tmiw/SM1000neo/schematic/v1.0/ezDV.step

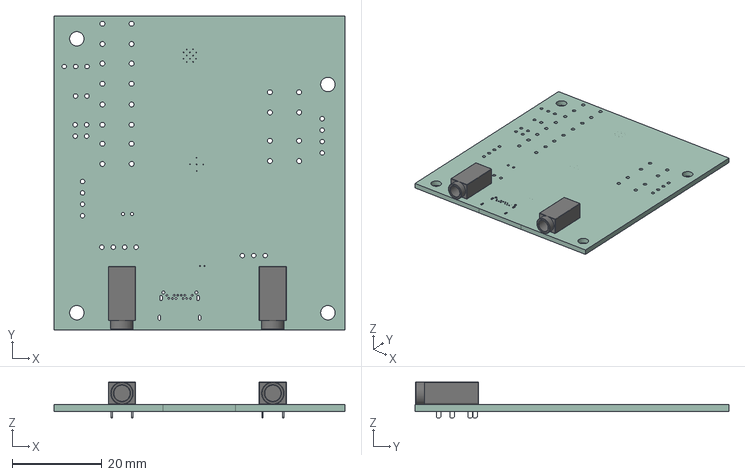
[picture p1: CAD file, 2024-10-30]
schematic/v1.0/ezDV.step
64.8 x 69.9 x 8.00 mm
ezDV PCB
