tmiw/SM1000neo/schematic/v1.0/ESD122DMXR.step

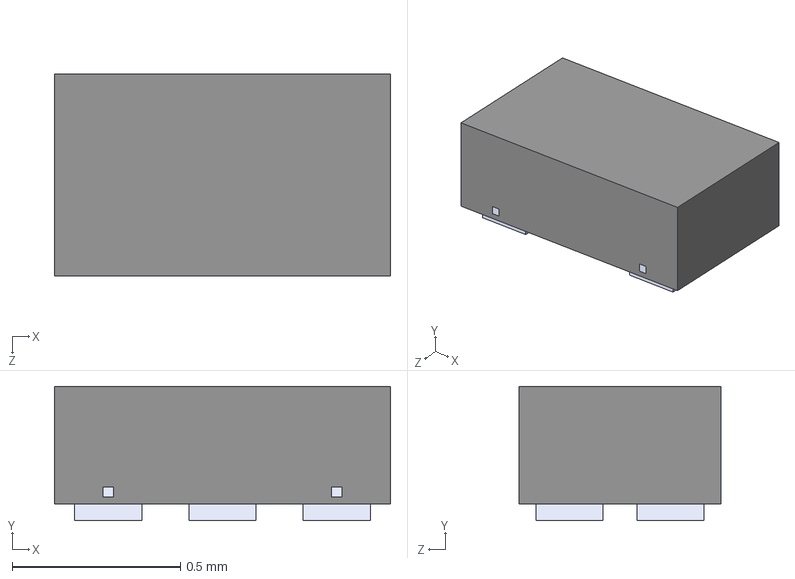
[picture p2: CAD file, 2024-10-30]
schematic/v1.0/ESD122DMXR.step
1.00 x 0.4 x 0.6 mm
