tmiw/SM1000neo/schematic/v1.0/BGA4N35P2X2_64X64X33N.step

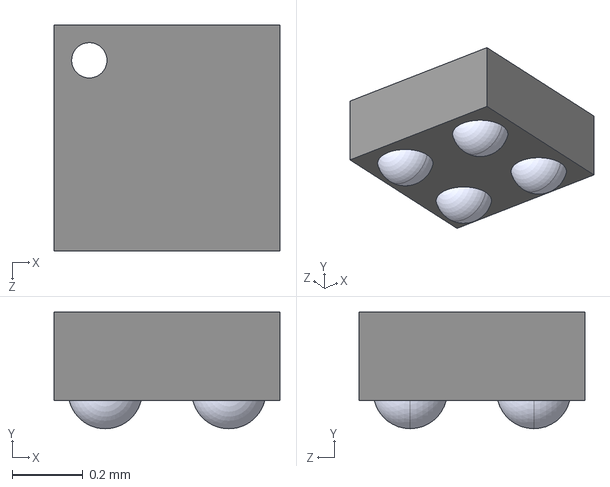
[picture p3: CAD file, 2024-10-30]
schematic/v1.0/BGA4N35P2X2_64X64X33N.step
0.64 x 0.33 x 0.64 mm
