tmiw/SM1000neo/schematic/v1.0/TPD1E05U06DPYR.step

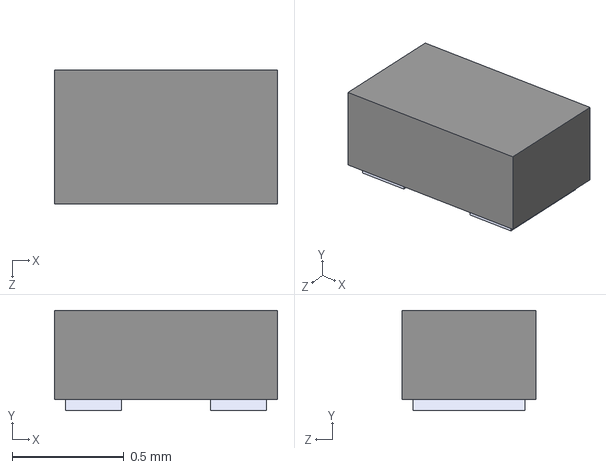
[picture p4: CAD file, 2024-10-30]
schematic/v1.0/TPD1E05U06DPYR.step
1.00 x 0.45 x 0.6 mm
