tmiw/SM1000neo/schematic/v1.0/TP4056.step

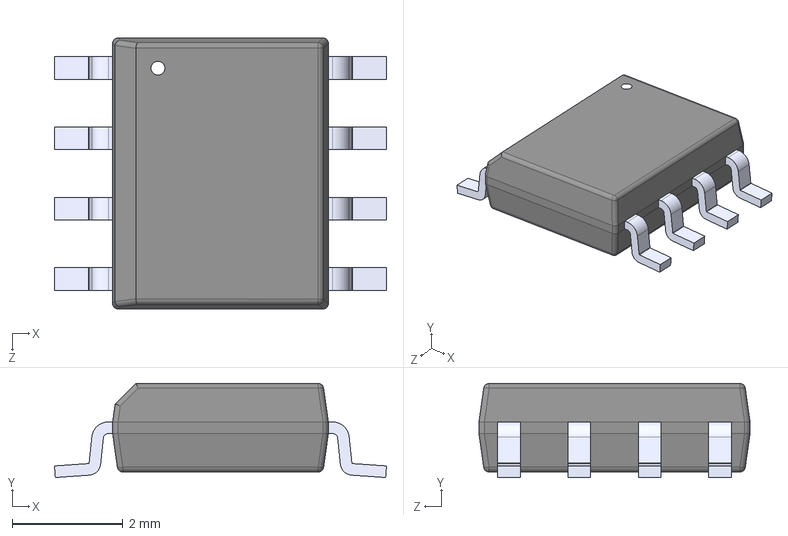
[picture p5: CAD file, 2024-10-30]
schematic/v1.0/TP4056.step
6.00 x 1.70 x 4.90 mm
