tmiw/SM1000neo/(threads)

Thread 2 (2022-05-06):

Evaluate and increase sizes of power traces

tmiw, 2022-05-06:
Some power traces may be insufficiently wide for the current being drawn. Investigate to confirm and update the PCB accordingly.

tmiw, 2022-05-29:
After rerouting of the PCB, the default trace width (0.25mm) was found to be sufficient for up to 1A of current at the top layer. The TLV320 as well as other components are unlikely to consume anywhere close to this current, so the issue can be closed.

Closed 2022-05-29.

Thread 3 (2022-05-06):

Remove button pullup resistors

tmiw, 2022-05-06:
The ESP32-S3 has internal pullups which may make R9, R12, R13 and R15 unnecessary. Evaluate and remove if those internal pullups are usable.

tmiw, 2022-05-28:
Closing for now as the current pullups seem to work okay.

Closed 2022-05-28.

Thread 4 (2022-05-06):

Evaluate size of I2C pullups

tmiw, 2022-05-06:
The I2C pullup resistors (R2 and R8) are currently 4.7K. This may be insufficient depending on how fast we drive the I2C bus. Investigate and increase the resistance if necessary.

tmiw, 2022-05-28:
I2C bus is able to be driven at 100KHz using 4.7K, so keeping as is.

Closed 2022-05-28.

Thread 5 (2022-05-06):

Add mounting holes for the dev board

tmiw, 2022-05-06:
v0.1 does not have any mounting holes. Adding some will eventually be needed for the final version or even future dev boards, so evaluate to determine what size/how many is appropriate.

Closed 2022-05-29.

Thread 6 (2022-05-06):

Evaluate and adjust resistor sizes for LEDs

tmiw, 2022-05-06:
The currents through each of the LEDs on v0.1 (R10, R14, R17 and R20) may produce dramatically different brightness levels. We can use PWM as a workaround but these should be readjusted based on the selected LEDs so that the brightness is approximately equal.

Closed 2022-05-29.

Thread 7 (2022-05-06):

Fix silkscreen readability issues

tmiw, 2022-05-06:
The EMC vias added just prior to sending the board to JLCPCB are interfering with some of the sillkscreen items. Move or delete the vias as appropriate so that the text is readable.

Closed 2022-05-29.

Thread 8 (2022-05-15):

Consider making R1 1k to increase mic bias current

tmiw, 2022-05-15:
Currently R1 is 2.7k (derived from the typical application schematic for the TLV320). However, this only allows 1mA of current to the microphone; the Android specs indicate 1.8-2.9 mA according to [this post](https://webcache.googleusercontent.com/search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). A 1k resistor instead would result in 2.5mA of current @ 2.5V, which would be within spec.

Closed 2022-05-29.

Thread 9 (2022-05-15):

Move I2C SCL to GPIO 45

tmiw, 2022-05-15:
v0.1 of the board has SCL on GPIO 48. However, the nanoESP32-S3 is apparently using that for its RGB LED. Cutting off the pin on the board for GPIO 45 and bodging the pin next to it to 45 allowed I2C to work properly.

Closed 2022-05-29.

Thread 10 (2022-05-17):

60Hz noise getting into headset mic line

tmiw, 2022-05-17:
Testing of the v0.1 boards show that significant 60Hz noise is getting into the mic line on the headset jack. The radio jack is working properly, however. For v0.2, we need to reroute this trace to shorten it and provide more shielding.

tmiw, 2022-06-25:
Looks like this was a firmware issue and not a HW issue. Still, v0.2 was worthwhile to spin. 👍

Closed 2022-06-25.

Thread 13 (2022-09-24):

Transition away from GitHub

tmiw, 2022-09-24:
As other FreeDV projects are transitioning away from GitHub, ezDV probably should too (context [here](https://sfconservancy.org/blog/2022/jun/30/give-up-github-launch/)). This issue is being created to track this task.

TODO:

* Research Git hosting providers (GitLab, SFC's own, etc.)
* Select Git hosting provider (w/vote by the Leadership Team)
* Clone current repo at new provider
* Re-enable/port CI tasks as appropriate
* Add link from GitHub to new location
* Make repository read-only mirror of new location
* Determine future date when to delete GitHub repository entirely

Related issues on other projects: codec2 (https://github.com/drowe67/codec2/issues/354), LPCNet (https://github.com/drowe67/LPCNet/issues/46), freedv-gui (https://github.com/drowe67/freedv-gui/issues/281)

Thread 14 (2022-10-13):

Thermistor is on incorrect GPIO pin

tmiw, 2022-10-13:
Oops. Turns out that the ADC only works on GPIOs 1-20 on the ESP32-S3. Reassign GPIO appropriately for next board spin.

tmiw, 2022-10-15:
Bodging to GPIO 18 for now. Final placement will be on v0.5 board.

tmiw, 2022-12-23:
Change has been integrated as of v0.5.

Closed 2022-12-23.

Thread 15 (2022-10-13):

High power consumption while off

tmiw, 2022-10-13:
Measuring ~890uA on v0.4 when turned off and USB is not plugged in. Per component datasheets, we should be seeing about 1/4-1/3 of that amount of consumption.

tmiw, 2022-12-23:
There were several causes:

1. The ULP coprocessor consumes more power than initially thought. SW changes (putting fuel gauge chip into hibernate manually as well as only activating the ULP 10x/sec to check the Mode button state) cut power consumption from ~770 uA to ~365 uA.
2. The pullup for `TLV320_RESET` was attached to `3.3V` instead of `3.3V_PERIPH`, causing ~300+ uA of leakage current to flow through the TLV320/ESP32 to the rest of the system. Desoldering R17 on v0.5 cut power consumption to ~50 uA after performing the changes in (1).

R17 has been removed in the schematic in `master` and will be integrated in the next board spin. While the board now meets the target (>= 1 year powered off before a 2000 mAh battery dies), there is still room for further improvement through selection of a different LDO. Keeping this issue open until we decide whether the LDO should be replaced.

tmiw, 2023-02-19:
v0.6 brought this down to ~25uA, so we can close this issue now.

Closed 2023-02-19.

Thread 16 (2022-10-13):

Microphone noise with TLV320 headset detection turned on

tmiw, 2022-10-13:
With headset detection turned on, there's some sort of background noise in the audio while in loopback mode. May need to inspect this part of the circuit again and ensure any RFI, etc. is taken care of.

tmiw, 2022-12-23:
Rerouted headset detect trace in v0.5 and resolved this issue.

Closed 2022-12-23.

Thread 17 (2022-10-18):

Move LED/PTT GPIO to RTC GPIO

tmiw, 2022-10-18:
Some LEDs are on dimly in sleep mode, which could be contributing to the high power consumption (see #15). For v0.5, we should switch the GPIOs around to avoid this issue.

tmiw, 2022-12-23:
LEDs are controlled via `3.3V_PERIPH` as of HW revision v0.5.

Closed 2022-12-23.

Thread 18 (2022-12-23):

Network LED much dimmer than the others

tmiw, 2022-12-23:
After desoldering R17 (see #15), I noticed that the network LED was much dimmer than the others. As a workaround, I enabled PWM on the LED GPIOs (https://github.com/tmiw/ezDV/commit/b49d4518e9d7d4edd33408c669c34078d787b349) and set it to ~10% duty cycle to minimize the dimming.  Needs more investigation to determine if there's a hardware problem.

tmiw, 2022-12-26:
Appears to be a firmware bug, fixed as of https://github.com/tmiw/ezDV/commit/c7b59d29f85121c067ee88c8e6f6925c029a9a6f.

Closed 2022-12-26.

Thread 19 (2023-07-20):

Crypto support + PCB manufacturing procedure

danielebruneo, 2023-07-20:
Hi,
I've been following your project and loving all the work you've done.

This overlap perfectly with a project I was researching on: building a crypto transciever based on an ESP (something similar to what aarmono did here: https://github.com/aarmono/crypto_transceiver_instructions but cheaper and smaller).

I would then like to start contributing to your project, maybe trying to port the work aarmono did on top of codec2 to build encryption support. (Is this something you were already thinking about, maybe?)

First thing, though, I'd need to get some hardware to develop with.

Any chance there is a ready-to-go package or instructions to get a set of pcb manufactured by any PCBA provider?

oh2lak, 2023-07-20:
What is the need for encryption, as amateur radio traffic in 99% of the
countries do not allow encryption?

Br,
Erik OH2LAK

On Thu, 20 Jul 2023 at 12:32, danielebruneo ***@***.***>
wrote:

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

tmiw, 2023-07-20:
The BOM is built into the KiCad files, but there are specific settings you have to choose at JLCPCB to have it built properly. I'll write up a document on that when I have time (likely not until at least next week).

As for crypto support, I'll leave it to @danielebruneo's fork as ezDV itself is intended for amateur radio use.

tmiw, 2024-05-18:
Closing as dupe of #21.

Closed 2024-05-18.

Thread 20 (2023-08-28):

More options for the FreeDV (int) Reporter

barjac, 2023-08-28:
Since the QST article about FreeDV has been published it has become clear that the reporter needs to have more fine grained setting options.
It's great to see more stations on the bands, but on 20m especially the reporter is becoming difficult to read in use.
Suggestions:
1 A filter to remove calls that have not been updated in the last N mins.
2 An option to only display (or highlight?) calls who have received me in the last N mins).
3 Show my own call line in a different colour.
4 An option to switch the reporter band filter automatically to the currently reported band (but only when that changes). i.e. The reporter band selector would still over-ride.

Just few ideas for discussion ;)

tmiw, 2023-08-28:
Please create this in the main freedv-gui repo instead as this has to do with functionality in that application. ezDV, while it does support reporting to FreeDV Reporter, has no internal display capability.

Closed 2023-08-28.

Thread 21 (2023-08-30):

ezDV build process document

g0kao, 2023-08-30:
Suggested starter for documenting the build process for the ezDV module based on HW Version 0.7 and my experience so far.
[ezDV Build Process.pdf](https://github.com/tmiw/ezDV/files/12474881/ezDV.Build.Process.pdf)
I couldn't create a pull request to have it reviewed, possibly not authorised for this project
hope it is useful and review comments welcomed
I generated in Text Edit on the Mac and exported to PDF to add it here
Paul

tmiw, 2023-08-31:
Thanks for this! I'll take a closer look when I have a chance. There might be the possibility of having JLCPCB fully assemble the boards (so you'd only need to buy the battery separately) so the instructions will likely need modification when that happens.

Thread 22 (2023-09-05):

WiFi unable to disable

g0kao, 2023-09-05:
Testing the ezDV module using two radios, one IC-705 the other a Yaesu FTdx10, Wifi enabled for the 705 which seems to be working ok, but when trying to focus efforts on the dx10, am unable to disable the WiFi connectivity for the radio.
Whenever i untick the option for WiFi connectivity and try to save, it reverts back to previous settings without unticking the WiFi option.
Have to disable WiFi on the 705 to force connectivity to work with the dx10
Have updated to latest version of code just released via ota but no change in the WiFi issue

tmiw, 2023-09-05:
Do you see any red or green popup boxes on the page after you press Save? If you see a green "success" type message, keep in mind that Wi-Fi changes require a power cycle (or pushing the Reboot button in the web UI) to take effect.

g0kao, 2023-09-05:
I untick the wifi check box, the config clears, I click the Save button, the module resets itself
when it comes back online the wifi is still enabled.
I did an ota update with the new release but it didn.t change anything, should I try a fresh full reflash perhaps?

g0kao, 2023-09-05:
I reflashed the module as discussed, I haven't connected to the ic-705, i just enabled the wifi, reset the module, then when it came back I attempted to disable wifi to the radio and the same steps occurred as outlined above, wifi not disable to the radio. going to try something else like disabling wifi completely from the module as a complete reset of the wifi code and see what happens

g0kao, 2023-09-05:
Nope, cannot disable wifi either, very strange, if i click the reset button on the wifi radio page, it defaults to some preconfigured default info, the black circle continues circling with no other prompts, it appears that once configured it cannot be undone without a reflash for me anyway. I  have one last ditch idea, will let you know what happens

g0kao, 2023-09-05:
attached is a putty log, tried to disable radio wifi, didn't work, then tried to disable wifi as a service, that did not work either
[putty-ezDV-wifi-issue.txt](https://github.com/tmiw/ezDV/files/12525971/putty-ezDV-wifi-issue.txt)

tmiw, 2023-09-06:
Give tonight's release a shot and let me know how it goes: https://github.com/tmiw/ezDV/releases/tag/20230905

g0kao, 2023-09-06:
Thanks Mooneer, that has fixed the problem, I can disable wifi or the wifi radio connection and re-enable the radio connection as needed, thanks again

Closed 2023-09-06.

Thread 23 (2023-09-24):

revised enclosure top and buttons

g0kao, 2023-09-24:
Having had the enclosure built for me I discovered that when the module v0.7 was fitted, the top did not fit due to the headers fitted to the pcb, as a result I have adjusted the height of the top and the length of the buttons to cater for the new case height.
Attached are new scad files that I have created and successfully printed to fit this module.
enclosure-lid.scad
enclosure-button-v3.scad
[enclosure-new-files.zip](https://github.com/tmiw/ezDV/files/12709445/enclosure-new-files.zip)

tmiw, 2023-09-25:
Thanks for these. How are you routing the cables attached to the headers out? I didn't see any additional holes when I opened them in OpenSCAD.

g0kao, 2023-09-25:
On mine I haven't created any holes for leads to come out from headers, managed connectivity via audio TRRS sockets for DX10 and wifi for ic-705. When original case was made I drilled a hole in the lid directly above the dc connection for the battery and chopped the header pins down so the lid would fit enough with the help of electrical tape to hold it together :-)
Need to make a fix so that the 3d printed buttons don't fall out when the module is tipped over, I think some tiny rubber o-rings should do it if I can find some small enough :-)
Attached is pic of my completed module using the files uploaded on my 3d printer
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

tmiw, 2023-09-25:
Ah, okay. I actually intended the headers to be optional since most will either be using the 3.5mm jacks and/or Wi-Fi, but it won't hurt to update the main OpenSCAD files with an extra flag that can be set to print the bigger case.

Re: O-rings, that sounds like a pretty good idea. I was thinking post-processing by adding tiny dabs of glue to the bottoms of the buttons but that precludes removing them later :)

tmiw, 2023-09-26:
I integrated the changes you provided into the main `enclosure.scad` file. The taller enclosure can be requested by setting the below (near the top of the file) to true:

```
// Whether to print a taller enclosure to fit e.g. pin headers.
// Note: this weirdly has to be above the include line for some reason.
printTallerEnclosure = false;
```

and likewise for `enclosure-button.scad`:

```
// Whether to print a taller buttons (typically used when printing the taller enclosure).
printTallerButtons = false;
```

Let me know if that doesn't work for you and I can reopen and investigate further.

Closed 2023-09-26.

Thread 24 (2023-11-01):

System stuck if no MAX17048 is used

onemikedelta, 2023-11-01:
I planned to use this module without battery. Everything works however, if I try to connect web interface system reboots.
Library shouldn't try to read battery if ic is not found during boot process.
`
I (22945) ButtonArray: Button VolDown now 0
I (23925) SettingsTask: Committing pending settings to flash.
I (40405) wifi:new:<1,0>, old:<1,1>, ap:<1,1>, sta:<255,255>, prof:1
I (40405) wifi:station: 12:34:56:78:90:AB join, AID=1, bgn, 20
I (40405) WirelessTask: Wifi event: 14
I (40535) wifi:<ba-add>idx:2 (ifx:1, 12:75:8d:8e:1d:67), tid:0, ssn:0, winSize:64
I (40745) esp_netif_lwip: DHCP server assigned IP to a client, IP is: 192.168.4.2
I (40765) DVTask: Task FlexVitaTask started
I (57075) HttpServerTask: Sending file : /bootstrap.min.css.gz (27324 bytes)...
I (57195) HttpServerTask: File sending complete
I (57285) HttpServerTask: Sending file : /localstyle.css (3249 bytes)...
I (57295) HttpServerTask: File sending complete
I (57385) HttpServerTask: Sending file : /bootstrap.bundle.min.js.gz (23265 bytes)...
I (57485) HttpServerTask: File sending complete
I (57495) HttpServerTask: Sending file : /jquery-3.6.1.min.js.gz (30850 bytes)...
I (57625) HttpServerTask: File sending complete
I (57715) HttpServerTask: Sending file : /localscript.js (22156 bytes)...
I (57845) HttpServerTask: File sending complete
I (57885) HttpServerTask: Websocket connection opened
I (57885) HttpServerTask: Sending JSON message to socket 57
I (57885) HttpServerTask: Sending JSON message to socket 57
I (57885) HttpServerTask: Sending JSON message to socket 57
I (57895) HttpServerTask: Sending JSON message to socket 57
I (57895) HttpServerTask: Sending JSON message to socket 57
I (57895) HttpServerTask: Sending JSON message to socket 57
I (57905) HttpServerTask: Sending JSON message to socket 57

assert failed: void ezdv::driver::MAX17048::onRequestBatteryStateMessage_(ezdv::task::DVTask*, ezdv::driver::RequestBatteryStateMessage*) MAX17048.cpp:215 (success)

Backtrace: 0x40376016:0x3fca9000 0x40380f31:0x3fca9020 0x40388c26:0x3fca9040 0x42015eca:0x3fca9160 0x42127fca:0x3fca91e0 0x42016639:0x3fca9200 0x42016649:0x3fca9230 0x420162a9:0x3fca9250 0x420162bf:0x3fca9280 0x42022369:0x3fca92a0 0x420223d6:0x3fca92f0 0x42022415:0x3fca9310 0x4038459d:0x3fca9330

------------------
I (1202) MAX17048: Checking for device...
W (1302) MAX17048: Device not found; battery monitoring disabled.
I (1302) DVTask: Task MAX17048 started
I (1312) DVTask: Task LedArray started
I (1322) gpio: GPIO[4]| InputEn: 0| OutputEn: 0| OpenDrain: 0| Pullup: 1| Pulldown: 0| Intr:0
I (1322) gpio: GPIO[5]| InputEn: 0| OutputEn: 0| OpenDrain: 0| Pullup: 1| Pulldown: 0| Intr:0
I (1322) gpio: GPIO[6]| InputEn: 0| OutputEn: 0| OpenDrain: 0| Pullup: 1| Pulldown: 0| Intr:0
I (1322) gpio: GPIO[7]| InputEn: 0| OutputEn: 0| OpenDrain: 0| Pullup: 1| Pulldown: 0| Intr:0
I (1322) gpio: GPIO[0]| InputEn: 0| OutputEn: 0| OpenDrain: 0| Pullup: 1| Pulldown: 0| Intr:0
I (1322) DVTask: Task ButtonArray started
I (1332) TLV320Driver: reset TLV320
I (1332) TLV320Driver: configure clocks
I (1342) TLV320Driver: configure processing blocks
I (1342) TLV320Driver: configure LDOs
I (1342) TLV320Driver: configure routing for ADC
I (1352) TLV320Driver: configure routing for DAC
I (1602) ButtonArray: Button UsbPower now 1
I (3182) TLV320Driver: configuring interrupts
I (3182) gpio: GPIO[12]| InputEn: 0| OutputEn: 0| OpenDrain: 0| Pullup: 1| Pulldown: 0| Intr:0
I (3182) gpio: GPIO[14]| InputEn: 0| OutputEn: 0| OpenDrain: 0| Pullup: 1| Pulldown: 0| Intr:0
I (3182) TLV320Driver: all audio codec config complete
I (3182) DVTask: Task TLV320Driver started
W (3202) TLV320Driver: ADC overload! (Left/User = 1, Right/Radio = 0)
I (3292) DVTask: Task FreeDVTask started
I (3302) DVTask: Task AudioMixer started
I (3302) TLV320Driver: button state: 10
I (3312) DVTask: Task BeeperTask started
I (3322) VoiceKeyerTask: Starting VoiceKeyerTask
I (3322) DVTask: Task VoiceKeyerTask started
I (3332) UserInterfaceTask: Sending welcome message to beeper
I (3332) DVTask: Task UserInterfaceTask started
I (3332) BeeperTask: Got beeper message   ANA
I (3342) DVTask: Task WirelessTask started
I (3342) DVTask: Task MainApp started
I (3352) SettingsTask: Initializing NVS.
I (3352) SoftwareUpdateTask: Starting SoftwareUpdateTask
I (3352) DVTask: Task SoftwareUpdateTask started
I (3352) SettingsTask: Opening NVS handle.
I (3352) SettingsTask: leftChannelVolume: 10
I (3352) SettingsTask: rightChannelVolume: -35
I (3352) SettingsTask: wifiEnabled: 0
I (3352) SettingsTask: wifiMode: 0
I (3352) SettingsTask: wifiSecurity: 0
I (3352) SettingsTask: wifiChannel: 1
I (3352) SettingsTask: wifiSsid:
I (3362) TLV320Driver: Volume control: setting volume on register 65 to 10
I (3362) SettingsTask: wifiPassword: ********
I (3362) SettingsTask: radioEnabled: 0
I (3362) SettingsTask: headsetPtt: 0
I (3362) SettingsTask: timeOutTimer: 120
I (3362) SettingsTask: radioType: 0
I (3362) SettingsTask: radioHostname:
I (3362) SettingsTask: radioPort: 0
I (3362) SettingsTask: radioUsername:
I (3362) SettingsTask: radioPassword: ********
I (3362) UserInterfaceTask: Disallowing headset button from toggling PTT.
I (3362) SettingsTask: enableVoiceKeyer: 0
I (3362) SettingsTask: voiceKeyerNumberTimesToTransmit: 10
I (3362) SettingsTask: voiceKeyerSecondsToWaitAfterTransmit: 5
I (3362) SettingsTask: callsign:
I (3362) SettingsTask: gridSquare: UN00KN
I (3362) SettingsTask: ledDutyCycle: 8192
I (3362) SettingsTask: lastMode: 3
I (3362) DVTask: Task SettingsTask started
I (3362) FreeDV: Setting FreeDV mode to 3
I (3362) BeeperTask: Got beeper message   1600
I (3372) TLV320Driver: Volume control: setting volume on register 66 to -35

`

tmiw, 2023-11-01:
ezDV is intended for use with a battery. Did you simply not populate the chip when you built it, or did you make additional changes?

Regardless, there is logic in there to detect the presence of the MAX17048 but the result of that is apparently getting ignored. That should hopefully be a quick fix that I can get to tonight.

tmiw, 2023-11-02:
This should be fixed in 2f396cb. Please confirm and I can go ahead and close. Thanks for letting me know!

onemikedelta, 2023-11-02:
You are welcome, thank you for such a fast action. It works normal now. I didn't populated the chip on one pcb.
I tryed to solder on another pcb but it completely stopped booting.

`I (668) sleep: Configure to isolate all GPIO pins in sleep state
I (669) sleep: Enable automatic switching of GPIO sleep configuration
I (669) app_start: Starting scheduler on CPU0
I (669) app_start: Starting scheduler on CPU1
I (669) main_task: Started on CPU0
I (679) esp_psram: Reserving pool of 63K of internal memory for DMA/internal all                                     ocations
I (679) main_task: Calling app_main()
I (779) gpio: GPIO[1]| InputEn: 0| OutputEn: 0| OpenDrain: 0| Pullup: 1| Pulldow                                     n: 0| Intr:0
I (779) gpio: GPIO[2]| InputEn: 0| OutputEn: 0| OpenDrain: 0| Pullup: 1| Pulldow                                     n: 0| Intr:0
I (779) gpio: GPIO[15]| InputEn: 0| OutputEn: 0| OpenDrain: 0| Pullup: 1| Pulldo                                     wn: 0| Intr:0
I (779) gpio: GPIO[21]| InputEn: 0| OutputEn: 0| OpenDrain: 0| Pullup: 1| Pulldo                                     wn: 0| Intr:0
I (779) gpio: GPIO[16]| InputEn: 0| OutputEn: 0| OpenDrain: 0| Pullup: 1| Pulldo                                     wn: 0| Intr:0
I (779) app: Wakeup reason: 0
I (779) app: Power up mode: 2773393973
I (779) app: Woken up via ULP, booting...
I (779) main_task: Returned from app_main()
I (789) app: onTaskStart_
I (809) gpio: GPIO[3]| InputEn: 0| OutputEn: 0| OpenDrain: 0| Pullup: 1| Pulldow                                     n: 0| Intr:0
I (809) gpio: GPIO[9]| InputEn: 0| OutputEn: 0| OpenDrain: 0| Pullup: 1| Pulldow                                     n: 0| Intr:0
I (809) gpio: GPIO[10]| InputEn: 0| OutputEn: 0| OpenDrain: 0| Pullup: 1| Pulldo                                     wn: 0| Intr:0
I (809) gpio: GPIO[11]| InputEn: 0| OutputEn: 0| OpenDrain: 0| Pullup: 1| Pulldo                                     wn: 0| Intr:0
I (809) gpio: GPIO[12]| InputEn: 0| OutputEn: 0| OpenDrain: 0| Pullup: 1| Pulldo                                     wn: 0| Intr:0
I (809) gpio: GPIO[14]| InputEn: 0| OutputEn: 0| OpenDrain: 0| Pullup: 1| Pulldo                                     wn: 0| Intr:0
I (809) gpio: GPIO[13]| InputEn: 0| OutputEn: 0| OpenDrain: 0| Pullup: 1| Pulldo                                     wn: 0| Intr:0
I (809) gpio: GPIO[0]| InputEn: 0| OutputEn: 0| OpenDrain: 0| Pullup: 1| Pulldow                                     n: 0| Intr:0
I (819) gpio: GPIO[7]| InputEn: 0| OutputEn: 0| OpenDrain: 0| Pullup: 1| Pulldow                                     n: 0| Intr:0
I (819) gpio: GPIO[4]| InputEn: 0| OutputEn: 0| OpenDrain: 0| Pullup: 1| Pulldow                                     n: 0| Intr:0
I (829) MAX17048: Checking for device...
E (1829) DVTask: Was waiting for MAX17048 but timed out
W (1929) MAX17048: Device not found; battery monitoring disabled.
I (1929) DVTask: Task MAX17048 started

assert failed: void ezdv::task::DVTask::waitForOurs_(ezdv::task::DVTask*, TickTy                                     pe_t) [with ControlMessageType = ezdv::task::TaskControlCommon<3>; TickType_t =                                      long unsigned int] DVTask.h:346 (found)

Backtrace: 0x4037677a:0x3fcbca90 0x4038124d:0x3fcbcab0 0x40388faa:0x3fcbcad0 0x4                                     2021cdd:0x3fcbcbf0 0x42021d59:0x3fcbcc20 0x4200ac8c:0x3fcbcc60 0x42020e96:0x3fcb                                     cca0 0x42122b9d:0x3fcbccd0 0x42020559:0x3fcbcd00 0x4202111a:0x3fcbcd30 0x4202122                                     2:0x3fcbcd80 0x4202127d:0x3fcbcda0 0x40381c01:0x3fcbcdc0
`

tmiw, 2023-11-02:
I added a bit more timeout for the MAX17048 task based on my testing here with an earlier version that doesn't have the MAX17048. Hopefully that helps!

onemikedelta, 2023-11-02:
Now the battery part works perfect. Thank you again, 73

Closed 2023-11-02.

Thread 25 (2023-11-29):

Analog Bypass Feature

onemikedelta, 2023-11-29:
Analog Bypass
If we switch IN1_L and IN1_R in the future versions, it looks like we may have a low power analog bypass mode, which will reduce latency and we can put esp32 into sleep mode to save power.

We may add speaker amplifier to LOL line and internal mic to one of the available inputs, (preferably analog routable one). So, the device can be usable as an ordinary hand mike. I have added LM4871MX on my pcb and routed LOL to this pin, it works nice. We only need to implement some amplifier enable signal other than Sync output because this output flickers a lot and continuously turn amplifier on and off. I have tryed headphone detect interrupt to switch headphone/speaker channels however it is not working, probably allways connected radio channel is preventing that, not sure atm.

Just a few ideas, 73

tmiw, 2023-11-29:
I remember the TLV320 being pretty low power even without using its analog bypass mode. The ESP32-S3 (and the status LEDs to a smaller extent) by far use most of the power. That said, using the mixer amps may be possible for RX; see below from the Application Reference Guide:

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

(Basically, set HPL to MAR, which comes from IN1_R.)

However, on TX, the ESP32 would probably have to come back online to take back control of audio routing, which will take a second or two if coming from ULP sleep. Not sure users would be okay with that, to be honest.

onemikedelta, 2023-11-29:
The problem is we cannot route microphone to the radio in this configuration if I am not missing a path. MAL to HPR is not supported. For the PTT, we may introduce a simple diode from radio PTT to PTT button. Only thing that is not going to work is PTT LED. I haven't tryed to setup interrupt for button and use GPIO21 yet. Maybe we can achieve this ptt system without waking up mcu completely by using ULP.

tmiw, 2023-11-29:
I don't have the schematic in front of me but I think the PTT output pin is one that can be manipulated in ULP. Would just need hardware changes to enable the proper routing if you did want to be able to support low powered analog.

That said, switching from that mode would likely still take a few seconds, but that might still be okay. Let's put this on hold for now and consider for ezDV V2.

Thread 26 (2023-12-04):

Reporting page - add ability to report via reporter the current mode and frequency

g0kao, 2023-12-04:
A thought just came to me as I was using the module with my FTdx10 connected via rear port. The module doesn't report to FreeDV Reporter when being used as we have previously discussed when I was initially testing.
Could the module reporting page where Callsign and Locator are configured be updated to allow entry of Frequency and Mode currently being used?  most people will be using their computer maybe to change modes or just keep an eye on battery levels so would be a useful way of enabling reporting via reporter at the same time for those where the rigs cannot communicate to the module their settings.

tmiw, 2023-12-06:
Give https://github.com/tmiw/ezDV/releases/tag/20231206 a shot and let me know how it goes. If you have problems with that, I can go ahead and reopen this bug for further investigation.

Closed 2023-12-06.

Thread 27 (2023-12-05):

Analog Mode Rx not working after Tx

onemikedelta, 2023-12-05:
In analog mode audio routing is ok after device reset. Transmit is also ok. However, It is not routing back the radio audio to the user audio.
Used firmware: ezdv-20231122-full

tmiw, 2023-12-05:
I believe https://github.com/tmiw/ezDV/commit/89552ddb52b05465ed2de981ccec28808de11187 will fix this based on my testing with SmartSDR and the Flex 6300 here. The issue was that there was logic missing to return to RX mode when in analog; I suspect if you push the Mode button after letting go of PTT to switch to e.g. 700D (and then go back to analog), RX will start working fine again.

Anyway, feel free to update here if it's still not solved after the next FW update and I'll reopen and investigate further.

Closed 2023-12-05.

Thread 31 (2024-03-19):

ezDV does not unregister itself from SmartSDR

tmiw, 2024-03-19:
Currently there is logic in ezDV (in `FlexTcpTask.cpp`) that unregisters itself from Flex radios when shutting down, and could presumably be run as well after a brief disconnection. However, when running this logic, the radio itself crashes. Thus, in the current FW, this logic is disabled.

The crash is being tracked by FlexRadio as SMART-9473 and this issue will be open until confirmed to be fixed (and the logic can be reenabled).

Thread 41 (2024-05-18):

Add references to FlexRadio 8000 series

tmiw, 2024-05-18:
Current references in the web interface and user's guide mention the FlexRadio 6000 series, but these need to be updated due to [FlexRadio's announcement of the 8400/8600](https://www.flexradio.com/products/flex-8000-deposit/?sku=FLEX-8000-Deposit-FL) at the 2024 Dayton Hamvention. No breaking changes to their API are expected in the new lineup.

Closed 2024-05-24.

Thread 59 (2024-07-29):

ezDV firmware build issues

FreeRepositories, 2024-07-29:
Hi,
Trying to build the firmware,  (commit 7ee14a9 v1.1.0)  but it looks it cannot be built.
Seen that in Releases there is a pre-built firmware, I wonder what is happening.
Are the repo sources checked out, up to date ?

Tried this many times, with the same error results.

New environment, Ubuntu 24.04, fresh esp-idf v 5.3

In a nutshell, what is executed is

**git clone https://github.com/tmiw/ezDV.git**
**cd ezDV**
**git submodule update --init --checkout --recursive**
**cd firmware**
**idf.py build**

 and then it stops with

```
/home/user/esp/projects/ezDV/firmware/main/network/HttpServerTask.cpp:612:28: error: 'using ezdv::network::HttpServerTask::WebSocketList = class std::map<int, bool>' {aka 'class std::map<int, bool>'} has no member named 'contains'
  612 |     if (!activeWebSockets_.contains(message->fd))
      |                            ^~~~~~~~
/home/user/esp/projects/ezDV/firmware/main/network/HttpServerTask.cpp: In member function 'void ezdv::network::HttpServerTask::onHttpWebsocketDisconnectedMessage_(ezdv::task::DVTask*, HttpWebsocketDisconnectedMessage*)':
/home/user/esp/projects/ezDV/firmware/main/network/HttpServerTask.cpp:840:27: error: 'using ezdv::network::HttpServerTask::WebSocketList = class std::map<int, bool>' {aka 'class std::map<int, bool>'} has no member named 'contains'
  840 |     if (activeWebSockets_.contains(message->fd))
      |                           ^~~~~~~~
```

Here is the complete output from the clone and build process

```
user@user-VMware-Virtual-Platform:~/esp/projects$ git clone https://github.com/tmiw/ezDV.git
Cloning into 'ezDV'...
remote: Enumerating objects: 7373, done.
remote: Counting objects: 100% (625/625), done.
remote: Compressing objects: 100% (279/279), done.
remote: Total 7373 (delta 473), reused 468 (delta 346), pack-reused 6748
Receiving objects: 100% (7373/7373), 104.54 MiB | 6.18 MiB/s, done.
Resolving deltas: 100% (5528/5528), done.
user@user-VMware-Virtual-Platform:~/esp/projects$ cd ezDV
user@user-VMware-Virtual-Platform:~/esp/projects/ezDV$ git submodule update --init --checkout --recursive
Submodule 'enclosure/library/YAPP_Box' (https://github.com/mrWheel/YAPP_Box.git) registered for path 'enclosure/library/YAPP_Box'
Submodule 'firmware/externals/esp-dsp' (https://github.com/espressif/esp-dsp.git) registered for path 'firmware/externals/esp-dsp'
Submodule 'firmware/externals/tinyuntar' (https://github.com/tmiw/TinyUntar.git) registered for path 'firmware/externals/tinyuntar'
Submodule 'firmware/externals/uzlib' (https://github.com/tmiw/uzlib) registered for path 'firmware/externals/uzlib'
Cloning into '/home/user/esp/projects/ezDV/enclosure/library/YAPP_Box'...
Cloning into '/home/user/esp/projects/ezDV/firmware/externals/esp-dsp'...
Cloning into '/home/user/esp/projects/ezDV/firmware/externals/tinyuntar'...
Cloning into '/home/user/esp/projects/ezDV/firmware/externals/uzlib'...
Submodule path 'enclosure/library/YAPP_Box': checked out 'b18e996388dff5b3ce523cec2b26665ccb7059d4'
Submodule path 'firmware/externals/esp-dsp': checked out '71514173b58b960173b40c4ade9d15d372770a74'
Submodule path 'firmware/externals/tinyuntar': checked out 'bda54b1c12141c74f259b4893186556a72c0d052'
Submodule path 'firmware/externals/uzlib': checked out '6ffe173438baa8a41bb96e5ab658e9c254a4bcac'
user@user-VMware-Virtual-Platform:~/esp/projects/ezDV$ cd firmware
user@user-VMware-Virtual-Platform:~/esp/projects/ezDV/firmware$ idf.py build
Executing action: all (aliases: build)
Running cmake in directory /home/user/esp/projects/ezDV/firmware/build
Executing "cmake -G Ninja -DPYTHON_DEPS_CHECKED=1 -DPYTHON=/home/user/.espressif/python_env/idf5.3_py3.12_env/bin/python -DESP_PLATFORM=1 -DCCACHE_ENABLE=0 /home/user/esp/projects/ezDV/firmware"...
-- IDF_TARGET is not set, guessed 'esp32s3' from sdkconfig '/home/user/esp/projects/ezDV/firmware/sdkconfig'
-- Found Git: /usr/bin/git (found version "2.43.0")
-- The C compiler identification is GNU 13.2.0
-- The CXX compiler identification is GNU 13.2.0
-- The ASM compiler identification is GNU
-- Found assembler: /home/user/.espressif/tools/xtensa-esp-elf/esp-13.2.0_20240530/xtensa-esp-elf/bin/xtensa-esp32s3-elf-gcc
-- Detecting C compiler ABI info
-- Detecting C compiler ABI info - done
-- Check for working C compiler: /home/user/.espressif/tools/xtensa-esp-elf/esp-13.2.0_20240530/xtensa-esp-elf/bin/xtensa-esp32s3-elf-gcc - skipped
-- Detecting C compile features
-- Detecting C compile features - done
-- Detecting CXX compiler ABI info
-- Detecting CXX compiler ABI info - done
-- Check for working CXX compiler: /home/user/.espressif/tools/xtensa-esp-elf/esp-13.2.0_20240530/xtensa-esp-elf/bin/xtensa-esp32s3-elf-g++ - skipped
-- Detecting CXX compile features
-- Detecting CXX compile features - done
-- Building ESP-IDF components for target esp32s3
Dependencies lock doesn't exist, solving dependencies.
......Updating lock file at /home/user/esp/projects/ezDV/firmware/dependencies.lock
Processing 3 dependencies:
[1/3] espressif/esp_websocket_client (1.2.3)
[2/3] espressif/libsodium (1.0.20~1)
[3/3] idf (5.3.0)
-- Project sdkconfig file /home/user/esp/projects/ezDV/firmware/sdkconfig
-- Compiler supported targets: xtensa-esp-elf
-- Found Python3: /home/user/.espressif/python_env/idf5.3_py3.12_env/bin/python (found version "3.12.3") found components: Interpreter
-- Performing Test CMAKE_HAVE_LIBC_PTHREAD
-- Performing Test CMAKE_HAVE_LIBC_PTHREAD - Success
-- Found Threads: TRUE
-- Performing Test C_COMPILER_SUPPORTS_WFORMAT_SIGNEDNESS
-- Performing Test C_COMPILER_SUPPORTS_WFORMAT_SIGNEDNESS - Success
-- App "ezdv" version: 1.1.0
-- Adding linker script /home/user/esp/projects/ezDV/firmware/build/esp-idf/esp_system/ld/memory.ld
-- Adding linker script /home/user/esp/projects/ezDV/firmware/build/esp-idf/esp_system/ld/sections.ld.in
-- Adding linker script /home/user/esp/esp-idf/components/esp_rom/esp32s3/ld/esp32s3.rom.ld
-- Adding linker script /home/user/esp/esp-idf/components/esp_rom/esp32s3/ld/esp32s3.rom.api.ld
-- Adding linker script /home/user/esp/esp-idf/components/esp_rom/esp32s3/ld/esp32s3.rom.libgcc.ld
-- Adding linker script /home/user/esp/esp-idf/components/esp_rom/esp32s3/ld/esp32s3.rom.wdt.ld
-- Adding linker script /home/user/esp/esp-idf/components/esp_rom/esp32s3/ld/esp32s3.rom.version.ld
-- Adding linker script /home/user/esp/esp-idf/components/esp_rom/esp32s3/ld/esp32s3.rom.newlib.ld
-- Adding linker script /home/user/esp/esp-idf/components/soc/esp32s3/ld/esp32s3.peripherals.ld
Setting up Codec2...
-- Performing Test COMPILER_SUPPORTS_GNU11
-- Performing Test COMPILER_SUPPORTS_GNU11 - Success
-- Performing Test COMPILER_SUPPORTS_GNU99
-- Performing Test COMPILER_SUPPORTS_GNU99 - Success
-- Looking for include file stdlib.h
-- Looking for include file stdlib.h - found
-- Looking for include file string.h
-- Looking for include file string.h - found
-- Looking for __GNU_LIBRARY__
-- Looking for __GNU_LIBRARY__ - not found
-- Looking for _GNU_SOURCE
-- Looking for _GNU_SOURCE - not found
-- Looking for floor
-- Looking for floor - not found
-- Looking for ceil
-- Looking for ceil - not found
-- Looking for pow
-- Looking for pow - not found
-- Looking for sqrt
-- Looking for sqrt - not found
-- Looking for sin
-- Looking for sin - not found
-- Looking for cos
-- Looking for cos - not found
-- Looking for atan2
-- Looking for atan2 - not found
-- Looking for log10
-- Looking for log10 - not found
-- Looking for round
-- Looking for round - not found
-- Looking for getopt
-- Looking for getopt - found
-- codec2 version: 1.2.0
-- Build type is: Debug
-- Compiler Flags: -mlongcalls  -fno-builtin-memcpy -fno-builtin-memset -fno-builtin-bzero -fno-builtin-stpcpy -fno-builtin-strncpy -Wall -Wno-strict-overflow -std=gnu11-g -O2 -DDUMP
-- Libraries linked:
-- Compilation date = XX2024-07-29XX
-- Adding linker script /home/user/esp/projects/ezDV/firmware/build/esp-idf/main/ulp_main/ulp_main.ld
-- Components: app_trace app_update bootloader bootloader_support bt cmock console cxx driver efuse esp-dsp esp-tls esp_adc esp_app_format esp_bootloader_format esp_coex esp_common esp_driver_ana_cmpr esp_driver_cam esp_driver_dac esp_driver_gpio esp_driver_gptimer esp_driver_i2c esp_driver_i2s esp_driver_isp esp_driver_jpeg esp_driver_ledc esp_driver_mcpwm esp_driver_parlio esp_driver_pcnt esp_driver_ppa esp_driver_rmt esp_driver_sdio esp_driver_sdm esp_driver_sdmmc esp_driver_sdspi esp_driver_spi esp_driver_tsens esp_driver_uart esp_driver_usb_serial_jtag esp_eth esp_event esp_gdbstub esp_hid esp_http_client esp_http_server esp_https_ota esp_https_server esp_hw_support esp_lcd esp_local_ctrl esp_mm esp_netif esp_netif_stack esp_partition esp_phy esp_pm esp_psram esp_ringbuf esp_rom esp_system esp_timer esp_vfs_console esp_wifi espcoredump espressif__esp_websocket_client espressif__libsodium esptool_py fatfs freertos hal heap http_parser idf_test ieee802154 json log lwip main mbedtls mqtt newlib nvs_flash nvs_sec_provider openthread partition_table perfmon protobuf-c protocomm pthread sdmmc soc spi_flash spiffs tcp_transport touch_element ulp unity usb vfs wear_levelling wifi_provisioning wpa_supplicant xtensa
-- Component paths: /home/user/esp/esp-idf/components/app_trace /home/user/esp/esp-idf/components/app_update /home/user/esp/esp-idf/components/bootloader /home/user/esp/esp-idf/components/bootloader_support /home/user/esp/esp-idf/components/bt /home/user/esp/esp-idf/components/cmock /home/user/esp/e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
-- Configuring done
-- Generating done
-- Build files have been written to: /home/user/esp/projects/ezDV/firmware/build
Running ninja in directory /home/user/esp/projects/ezDV/firmware/build
Executing "ninja all"...
[9/1426] Generating ../../partition_table/partition-table.bin
Partition table binary generated. Contents:
*******************************************************************************
# ESP-IDF Partition Table
# Name, Type, SubType, Offset, Size, Flags
nvs,data,nvs,0x9000,24K,
otadata,data,ota,0xf000,8K,
phy_init,data,phy,0x11000,4K,
ota_0,app,ota_0,0x20000,4000K,
ota_1,app,ota_1,0x410000,4000K,
http_0,data,spiffs,0x7f8000,1000K,
http_1,data,spiffs,0x8f2000,1000K,
vk,data,fat,0x9ec000,1000K,
*******************************************************************************
[196/1426] Performing configure step for 'bootloader'
-- Found Git: /usr/bin/git (found version "2.43.0")
-- The C compiler identification is GNU 13.2.0
-- The CXX compiler identification is GNU 13.2.0
-- The ASM compiler identification is GNU
-- Found assembler: /home/user/.espressif/tools/xtensa-esp-elf/esp-13.2.0_20240530/xtensa-esp-elf/bin/xtensa-esp32s3-elf-gcc
-- Detecting C compiler ABI info
-- Detecting C compiler ABI info - done
-- Check for working C compiler: /home/user/.espressif/tools/xtensa-esp-elf/esp-13.2.0_20240530/xtensa-esp-elf/bin/xtensa-esp32s3-elf-gcc - skipped
-- Detecting C compile features
-- Detecting C compile features - done
-- Detecting CXX compiler ABI info
-- Detecting CXX compiler ABI info - done
-- Check for working CXX compiler: /home/user/.espressif/tools/xtensa-esp-elf/esp-13.2.0_20240530/xtensa-esp-elf/bin/xtensa-esp32s3-elf-g++ - skipped
-- Detecting CXX compile features
-- Detecting CXX compile features - done
-- Building ESP-IDF components for target esp32s3
-- Project sdkconfig file /home/user/esp/projects/ezDV/firmware/sdkconfig
-- Compiler supported targets: xtensa-esp-elf
-- Adding linker script /home/user/esp/esp-idf/components/soc/esp32s3/ld/esp32s3.peripherals.ld
-- Bootloader project name: "bootloader" version: 1
-- Adding linker script /home/user/esp/esp-idf/components/esp_rom/esp32s3/ld/esp32s3.rom.ld
-- Adding linker script /home/user/esp/esp-idf/components/esp_rom/esp32s3/ld/esp32s3.rom.api.ld
-- Adding linker script /home/user/esp/esp-idf/components/esp_rom/esp32s3/ld/esp32s3.rom.libgcc.ld
-- Adding linker script /home/user/esp/esp-idf/components/esp_rom/esp32s3/ld/esp32s3.rom.wdt.ld
-- Adding linker script /home/user/esp/esp-idf/components/esp_rom/esp32s3/ld/esp32s3.rom.version.ld
-- Adding linker script /home/user/esp/esp-idf/components/esp_rom/esp32s3/ld/esp32s3.rom.newlib.ld
-- Adding linker script /home/user/esp/esp-idf/components/bootloader/subproject/main/ld/esp32s3/bootloader.ld
-- Adding linker script /home/user/esp/esp-idf/components/bootloader/subproject/main/ld/esp32s3/bootloader.rom.ld
-- Components: bootloader bootloader_support efuse esp_app_format esp_bootloader_format esp_common esp_hw_support esp_rom esp_system esptool_py freertos hal log main micro-ecc newlib partition_table soc spi_flash xtensa
-- Component paths: /home/user/esp/esp-idf/components/bootloader /home/user/esp/esp-idf/components/bootloader_support /home/user/esp/esp-idf/components/efuse /home/user/esp/esp-idf/components/esp_app_format /home/user/esp/esp-idf/components/esp_bootloader_format /home/user/esp/esp-idf/components/esp_common /home/user/esp/esp-idf/components/esp_hw_support /home/user/esp/esp-idf/components/esp_rom /home/user/esp/esp-idf/components/esp_system /home/user/esp/esp-idf/components/esptool_py /home/user/esp/esp-idf/components/freertos /home/user/esp/esp-idf/components/hal /home/user/esp/esp-idf/components/log /home/user/esp/esp-idf/components/bootloader/subproject/main /home/user/esp/esp-idf/components/bootloader/subproject/components/micro-ecc /home/user/esp/esp-idf/components/newlib /home/user/esp/esp-idf/components/partition_table /home/user/esp/esp-idf/components/soc /home/user/esp/esp-idf/components/spi_flash /home/user/esp/esp-idf/components/xtensa
-- Configuring done
-- Generating done
-- Build files have been written to: /home/user/esp/projects/ezDV/firmware/build/bootloader
[112/113] Generating binary image from built executable
esptool.py v4.8.dev4
Creating esp32s3 image...
Merged 2 ELF sections
Successfully created esp32s3 image.
Generated /home/user/esp/projects/ezDV/firmware/build/bootloader/bootloader.bin
[113/113] cd /home/user/esp/projects/ezDV/firmware/build/bootloader/esp-id... 0x0 /home/user/esp/projects/ezDV/firmware/build/bootloader/bootloader.bin
Bootloader binary size 0x5410 bytes. 0x2bf0 bytes (34%) free.
[846/1426] Performing configure step for 'ulp_main'
-- Found Git: /usr/bin/git (found version "2.43.0")
-- The ASM compiler identification is GNU
-- Found assembler: /home/user/.espressif/tools/riscv32-esp-elf/esp-13.2.0_20240530/riscv32-esp-elf/bin/riscv32-esp-elf-gcc
-- The C compiler identification is GNU 13.2.0
-- Detecting C compiler ABI info
-- Detecting C compiler ABI info - done
-- Check for working C compiler: /home/user/.espressif/tools/riscv32-esp-elf/esp-13.2.0_20240530/riscv32-esp-elf/bin/riscv32-esp-elf-gcc - skipped
-- Detecting C compile features
-- Detecting C compile features - done
-- Building ULP app ulp_main
-- Configuring done
-- Generating done
-- Build files have been written to: /home/user/esp/projects/ezDV/firmware/build/esp-idf/main/ulp_main
[883/1426] Performing configure step for 'codec2_native'
-- The C compiler identification is GNU 13.2.0
-- Detecting C compiler ABI info
-- Detecting C compiler ABI info - done
-- Check for working C compiler: /usr/bin/cc - skipped
-- Detecting C compile features
-- Detecting C compile features - done
-- Found Git: /usr/bin/git (found version "2.43.0")
-- Codec2 current git hash: 06d4c11
-- Performing Test COMPILER_SUPPORTS_GNU11
-- Performing Test COMPILER_SUPPORTS_GNU11 - Success
-- Performing Test COMPILER_SUPPORTS_GNU99
-- Performing Test COMPILER_SUPPORTS_GNU99 - Success
-- Looking for include file stdlib.h
-- Looking for include file stdlib.h - found
-- Looking for include file string.h
-- Looking for include file string.h - found
-- Looking for __GNU_LIBRARY__
-- Looking for __GNU_LIBRARY__ - found
-- Looking for floor
-- Looking for floor - not found
-- Looking for ceil
-- Looking for ceil - not found
-- Looking for pow
-- Looking for pow - not found
-- Looking for sqrt
-- Looking for sqrt - not found
-- Looking for sin
-- Looking for sin - not found
-- Looking for cos
-- Looking for cos - not found
-- Looking for atan2
-- Looking for atan2 - not found
-- Looking for log10
-- Looking for log10 - not found
-- Looking for round
-- Looking for round - not found
-- Looking for getopt
-- Looking for getopt - found
-- codec2 version: 1.2.0
-- Build type is: Debug
-- Compiler Flags:  -Wall -Wno-strict-overflow -std=gnu11 -fPIC-g -O2 -DDUMP
-- Libraries linked:
-- Compilation date = XX2024-07-29XX
-- Configuring done
-- Generating done
-- Build files have been written to: /home/user/esp/projects/ezDV/firmware/build/_deps/codec2-build/src/codec2_native
[1293/1426] Building C object _deps/codec2-build/src/CMakeFiles/codec2.dir/dump.c.obj
/home/user/esp/projects/ezDV/firmware/build/_deps/codec2-src/src/dump.c: In function 'dump_Sn':
/home/user/esp/projects/ezDV/firmware/build/_deps/codec2-src/src/dump.c:124:60: warning: implicit conversion from 'float' to 'double' when passing argument to function [-Wdouble-promotion]
  124 |   for (i = 0; i < m_pitch / 2; i++) fprintf(fsn, "%f\t", Sn[i]);
      |                                                          ~~^~~
/home/user/esp/projects/ezDV/firmware/build/_deps/codec2-src/src/dump.c:126:66: warning: implicit conversion from 'float' to 'double' when passing argument to function [-Wdouble-promotion]
  126 |   for (i = m_pitch / 2; i < m_pitch; i++) fprintf(fsn, "%f\t", Sn[i]);
      |                                                                ~~^~~
/home/user/esp/projects/ezDV/firmware/build/_deps/codec2-src/src/dump.c: In function 'dump_Sw':
/home/user/esp/projects/ezDV/firmware/build/_deps/codec2-src/src/dump.c:144:18: warning: implicit conversion from 'float' to 'double' to match other operand of binary expression [-Wdouble-promotion]
  144 |             10.0 * log10(Sw[i].real * Sw[i].real + Sw[i].imag * Sw[i].imag));
      |                  ^
/home/user/esp/projects/ezDV/firmware/build/_deps/codec2-src/src/dump.c: In function 'dump_Sw_':
/home/user/esp/projects/ezDV/firmware/build/_deps/codec2-src/src/dump.c:163:14: warning: implicit conversion from 'float' to 'double' to match other operand of binary expression [-Wdouble-promotion]
  163 |         10.0 * log10(Sw_[i].real * Sw_[i].real + Sw_[i].imag * Sw_[i].imag));
      |              ^
/home/user/esp/projects/ezDV/firmware/build/_deps/codec2-src/src/dump.c: In function 'dump_Ew':
/home/user/esp/projects/ezDV/firmware/build/_deps/codec2-src/src/dump.c:181:18: warning: implicit conversion from 'float' to 'double' to match other operand of binary expression [-Wdouble-promotion]
  181 |             10.0 * log10(Ew[i].real * Ew[i].real + Ew[i].imag * Ew[i].imag));
      |                  ^
/home/user/esp/projects/ezDV/firmware/build/_deps/codec2-src/src/dump.c: In function 'dump_softdec':
/home/user/esp/projects/ezDV/firmware/build/_deps/codec2-src/src/dump.c:197:60: warning: implicit conversion from 'float' to 'double' when passing argument to function [-Wdouble-promotion]
  197 |   for (i = 0; i < n; i++) fprintf(fsoftdec, "%f\t", softdec[i]);
      |                                                     ~~~~~~~^~~
/home/user/esp/projects/ezDV/firmware/build/_deps/codec2-src/src/dump.c: In function 'dump_model':
/home/user/esp/projects/ezDV/firmware/build/_deps/codec2-src/src/dump.c:214:36: warning: implicit conversion from 'float' to 'double' when passing argument to function [-Wdouble-promotion]
  214 |   sprintf(line, "%12f %12d ", model->Wo, model->L);
      |                               ~~~~~^~~~
/home/user/esp/projects/ezDV/firmware/build/_deps/codec2-src/src/dump.c:216:33: warning: implicit conversion from 'float' to 'double' when passing argument to function [-Wdouble-promotion]
  216 |     sprintf(s, "%12f ", model->A[l]);
      |                         ~~~~~~~~^~~
/home/user/esp/projects/ezDV/firmware/build/_deps/codec2-src/src/dump.c:221:25: warning: implicit conversion from 'float' to 'double' when passing argument to function [-Wdouble-promotion]
  221 |     sprintf(s, "%12f ", 0.0);
      |                         ^~~
/home/user/esp/projects/ezDV/firmware/build/_deps/codec2-src/src/dump.c: In function 'dump_quantised_model':
/home/user/esp/projects/ezDV/firmware/build/_deps/codec2-src/src/dump.c:244:36: warning: implicit conversion from 'float' to 'double' when passing argument to function [-Wdouble-promotion]
  244 |   sprintf(line, "%12f %12d ", model->Wo, model->L);
      |                               ~~~~~^~~~
/home/user/esp/projects/ezDV/firmware/build/_deps/codec2-src/src/dump.c:246:33: warning: implicit conversion from 'float' to 'double' when passing argument to function [-Wdouble-promotion]
  246 |     sprintf(s, "%12f ", model->A[l]);
      |                         ~~~~~~~~^~~
/home/user/esp/projects/ezDV/firmware/build/_deps/codec2-src/src/dump.c:251:25: warning: implicit conversion from 'float' to 'double' when passing argument to function [-Wdouble-promotion]
  251 |     sprintf(s, "%12f ", 0.0);
      |                         ^~~
/home/user/esp/projects/ezDV/firmware/build/_deps/codec2-src/src/dump.c: In function 'dump_phase':
/home/user/esp/projects/ezDV/firmware/build/_deps/codec2-src/src/dump.c:273:57: warning: implicit conversion from 'float' to 'double' when passing argument to function [-Wdouble-promotion]
  273 |   for (l = 1; l <= L; l++) fprintf(fphase, "%f\t", phase[l]);
      |                                                    ~~~~~^~~
/home/user/esp/projects/ezDV/firmware/build/_deps/codec2-src/src/dump.c:274:62: warning: implicit conversion from 'float' to 'double' when passing argument to function [-Wdouble-promotion]
  274 |   for (l = L + 1; l <= MAX_AMP; l++) fprintf(fphase, "%f\t", 0.0);
      |                                                              ^~~
/home/user/esp/projects/ezDV/firmware/build/_deps/codec2-src/src/dump.c: In function 'dump_phase_':
/home/user/esp/projects/ezDV/firmware/build/_deps/codec2-src/src/dump.c:290:59: warning: implicit conversion from 'float' to 'double' when passing argument to function [-Wdouble-promotion]
  290 |   for (l = 1; l <= L; l++) fprintf(fphase_, "%f\t", phase_[l]);
      |                                                     ~~~~~~^~~
/home/user/esp/projects/ezDV/firmware/build/_deps/codec2-src/src/dump.c:291:62: warning: implicit conversion from 'float' to 'double' when passing argument to function [-Wdouble-promotion]
  291 |   for (l = L + 1; l < MAX_AMP; l++) fprintf(fphase_, "%f\t", 0.0);
      |                                                              ^~~
/home/user/esp/projects/ezDV/firmware/build/_deps/codec2-src/src/dump.c: In function 'dump_snr':
/home/user/esp/projects/ezDV/firmware/build/_deps/codec2-src/src/dump.c:322:25: warning: implicit conversion from 'float' to 'double' when passing argument to function [-Wdouble-promotion]
  322 |   fprintf(fsnr, "%f\n", snr);
      |                         ^~~
/home/user/esp/projects/ezDV/firmware/build/_deps/codec2-src/src/dump.c: In function 'dump_lpc_snr':
/home/user/esp/projects/ezDV/firmware/build/_deps/codec2-src/src/dump.c:336:28: warning: implicit conversion from 'float' to 'double' when passing argument to function [-Wdouble-promotion]
  336 |   fprintf(flpcsnr, "%f\n", snr);
      |                            ^~~
/home/user/esp/projects/ezDV/firmware/build/_deps/codec2-src/src/dump.c: In function 'dump_Pwb':
/home/user/esp/projects/ezDV/firmware/build/_deps/codec2-src/src/dump.c:353:62: warning: implicit conversion from 'float' to 'double' when passing argument to function [-Wdouble-promotion]
  353 |   for (i = 0; i < FFT_ENC / 2; i++) fprintf(fpwb, "%f\t", Pwb[i]);
      |                                                           ~~~^~~
/home/user/esp/projects/ezDV/firmware/build/_deps/codec2-src/src/dump.c: In function 'dump_Pw':
/home/user/esp/projects/ezDV/firmware/build/_deps/codec2-src/src/dump.c:369:60: warning: implicit conversion from 'float' to 'double' when passing argument to function [-Wdouble-promotion]
  369 |   for (i = 0; i < FFT_ENC / 2; i++) fprintf(fpw, "%f\t", Pw[i]);
      |                                                          ~~^~~
/home/user/esp/projects/ezDV/firmware/build/_deps/codec2-src/src/dump.c: In function 'dump_Rw':
/home/user/esp/projects/ezDV/firmware/build/_deps/codec2-src/src/dump.c:385:60: warning: implicit conversion from 'float' to 'double' when passing argument to function [-Wdouble-promotion]
  385 |   for (i = 0; i < FFT_ENC / 2; i++) fprintf(frw, "%f\t", Rw[i]);
      |                                                          ~~^~~
/home/user/esp/projects/ezDV/firmware/build/_deps/codec2-src/src/dump.c: In function 'dump_weights':
/home/user/esp/projects/ezDV/firmware/build/_deps/codec2-src/src/dump.c:401:58: warning: implicit conversion from 'float' to 'double' when passing argument to function [-Wdouble-promotion]
  401 |   for (i = 0; i < order; i++) fprintf(fweights, "%f\t", w[i]);
      |                                                         ~^~~
/home/user/esp/projects/ezDV/firmware/build/_deps/codec2-src/src/dump.c: In function
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
