tmiw/SM1000neo/schematic/v1.0/ezDV v0.8 Schematic.pdf

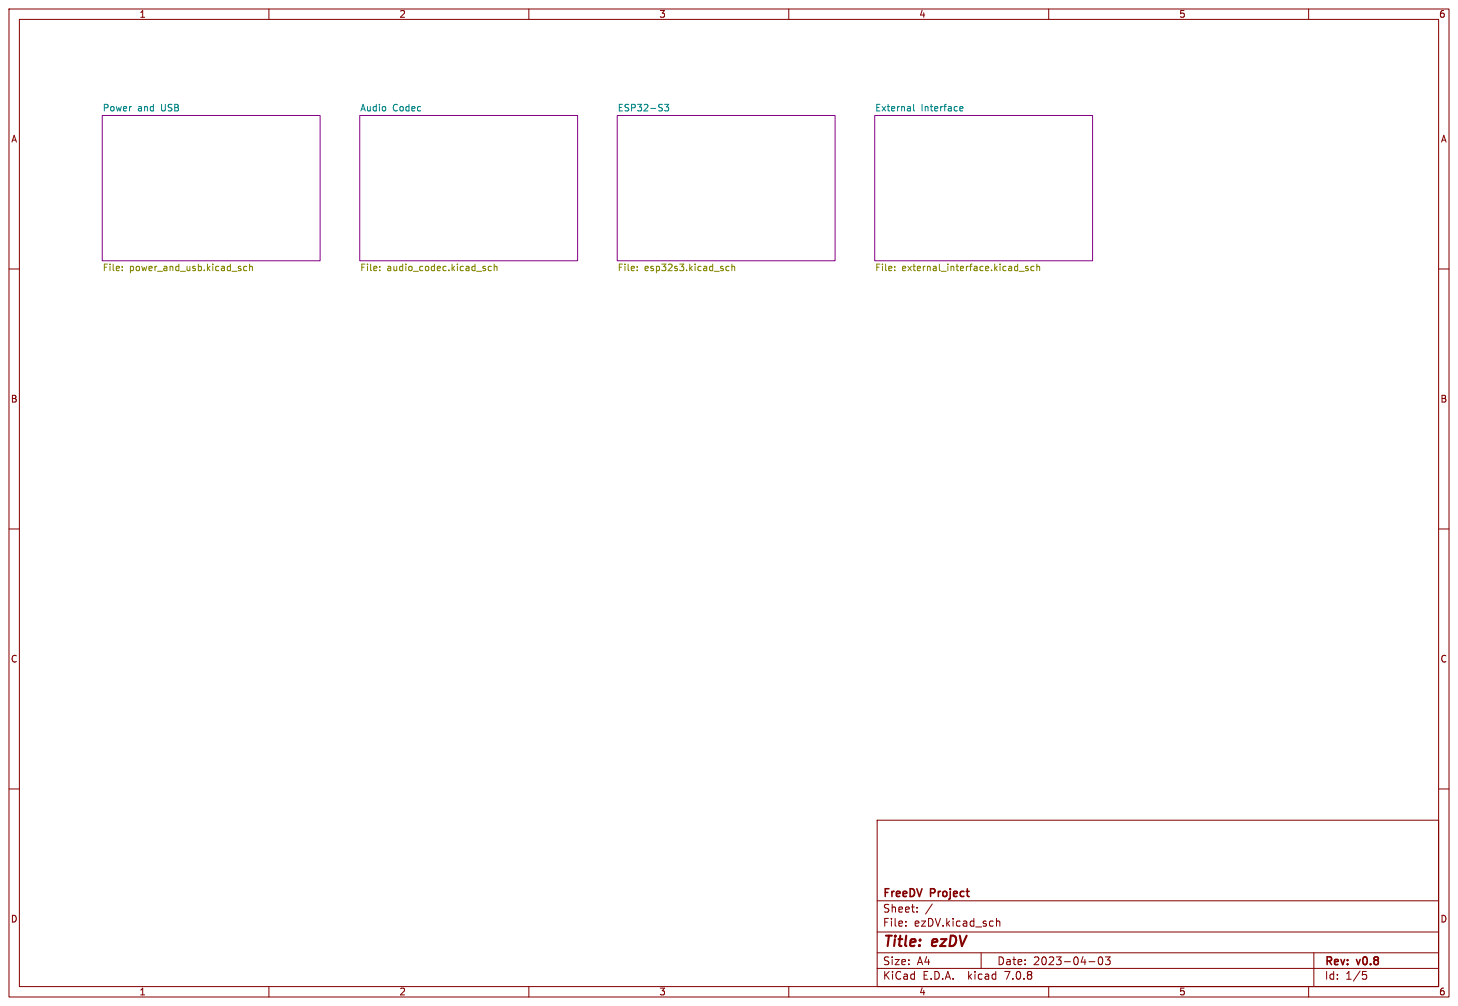
[picture p6: page 1]

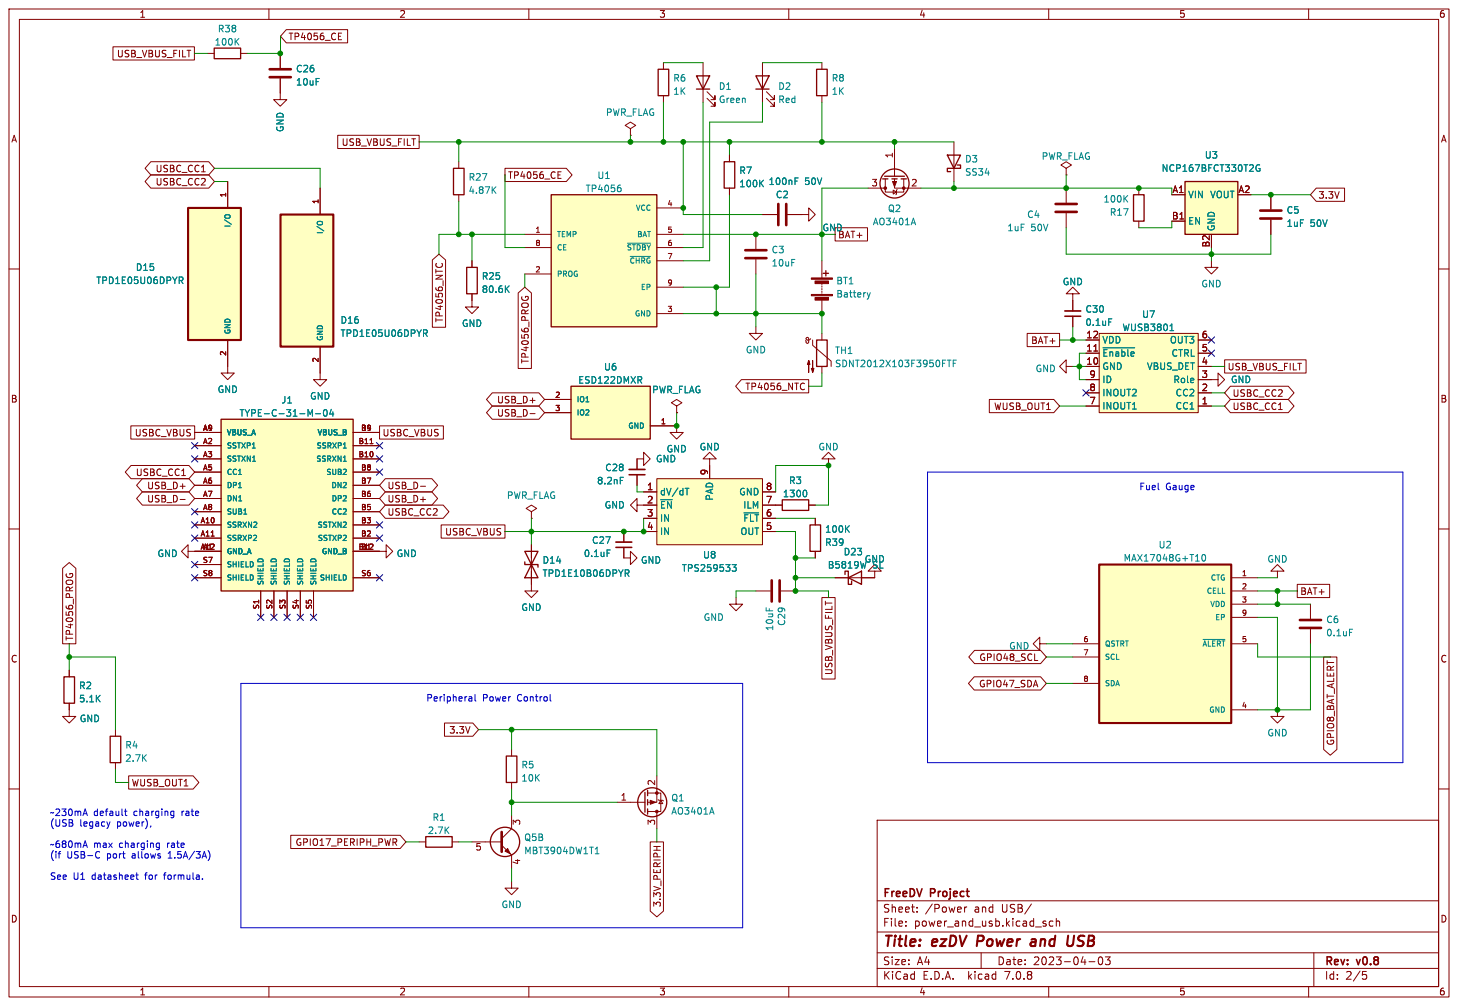
[picture p7: page 2]

Id: 2/5 Title: ezDV Power and USB

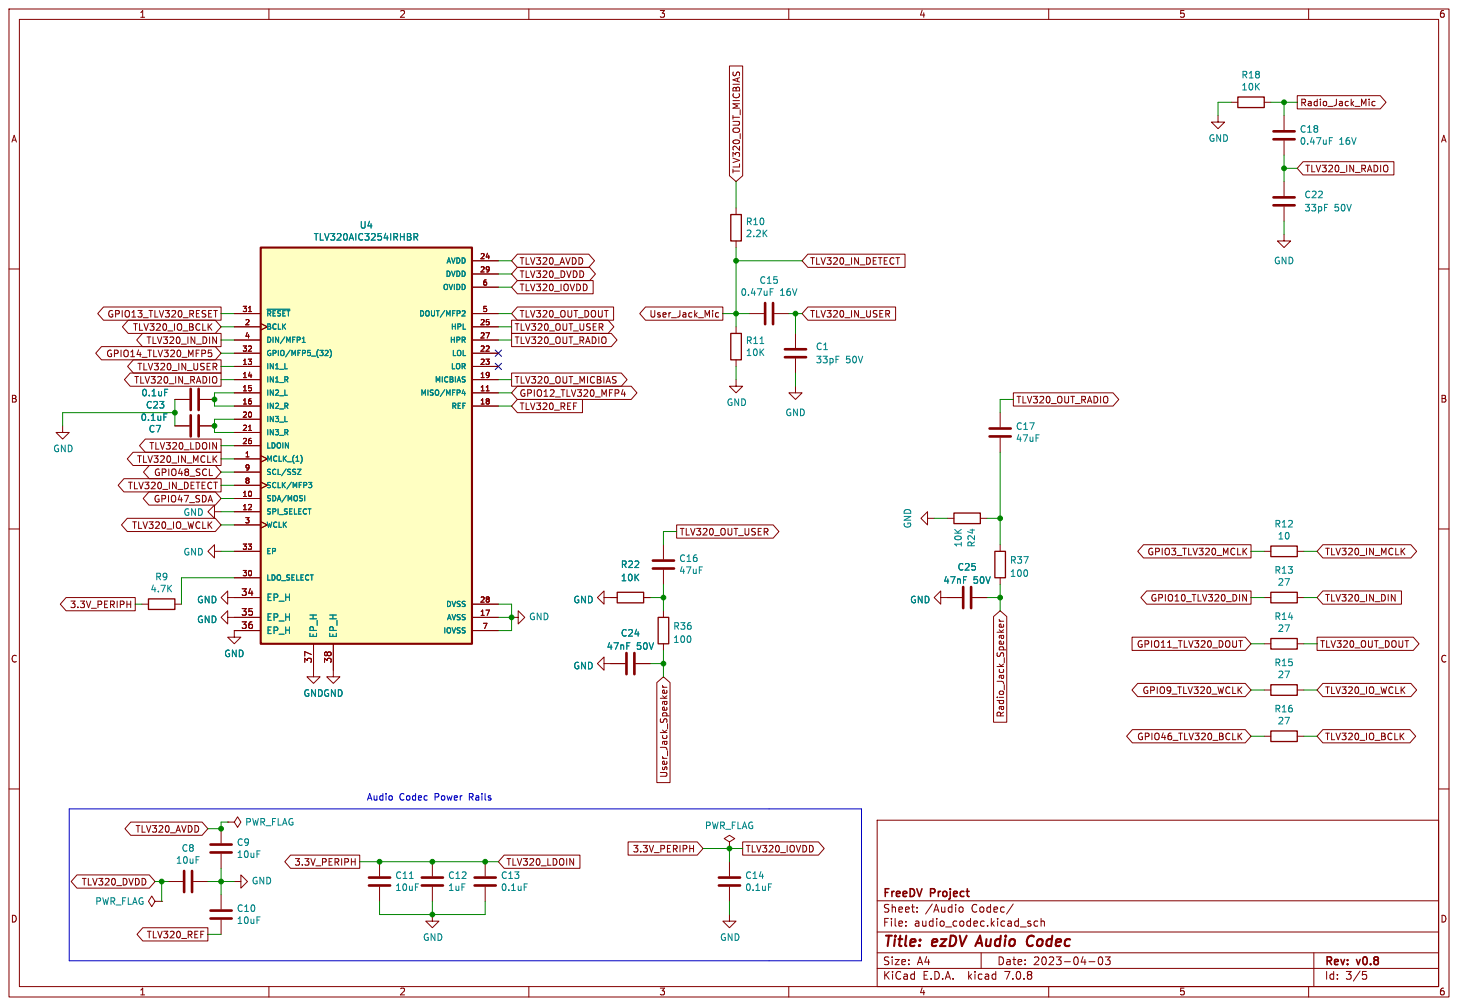
[picture p8: page 3]

Audio Codec Power Rails C23

Id: 3/5 Title: ezDV Audio Codec

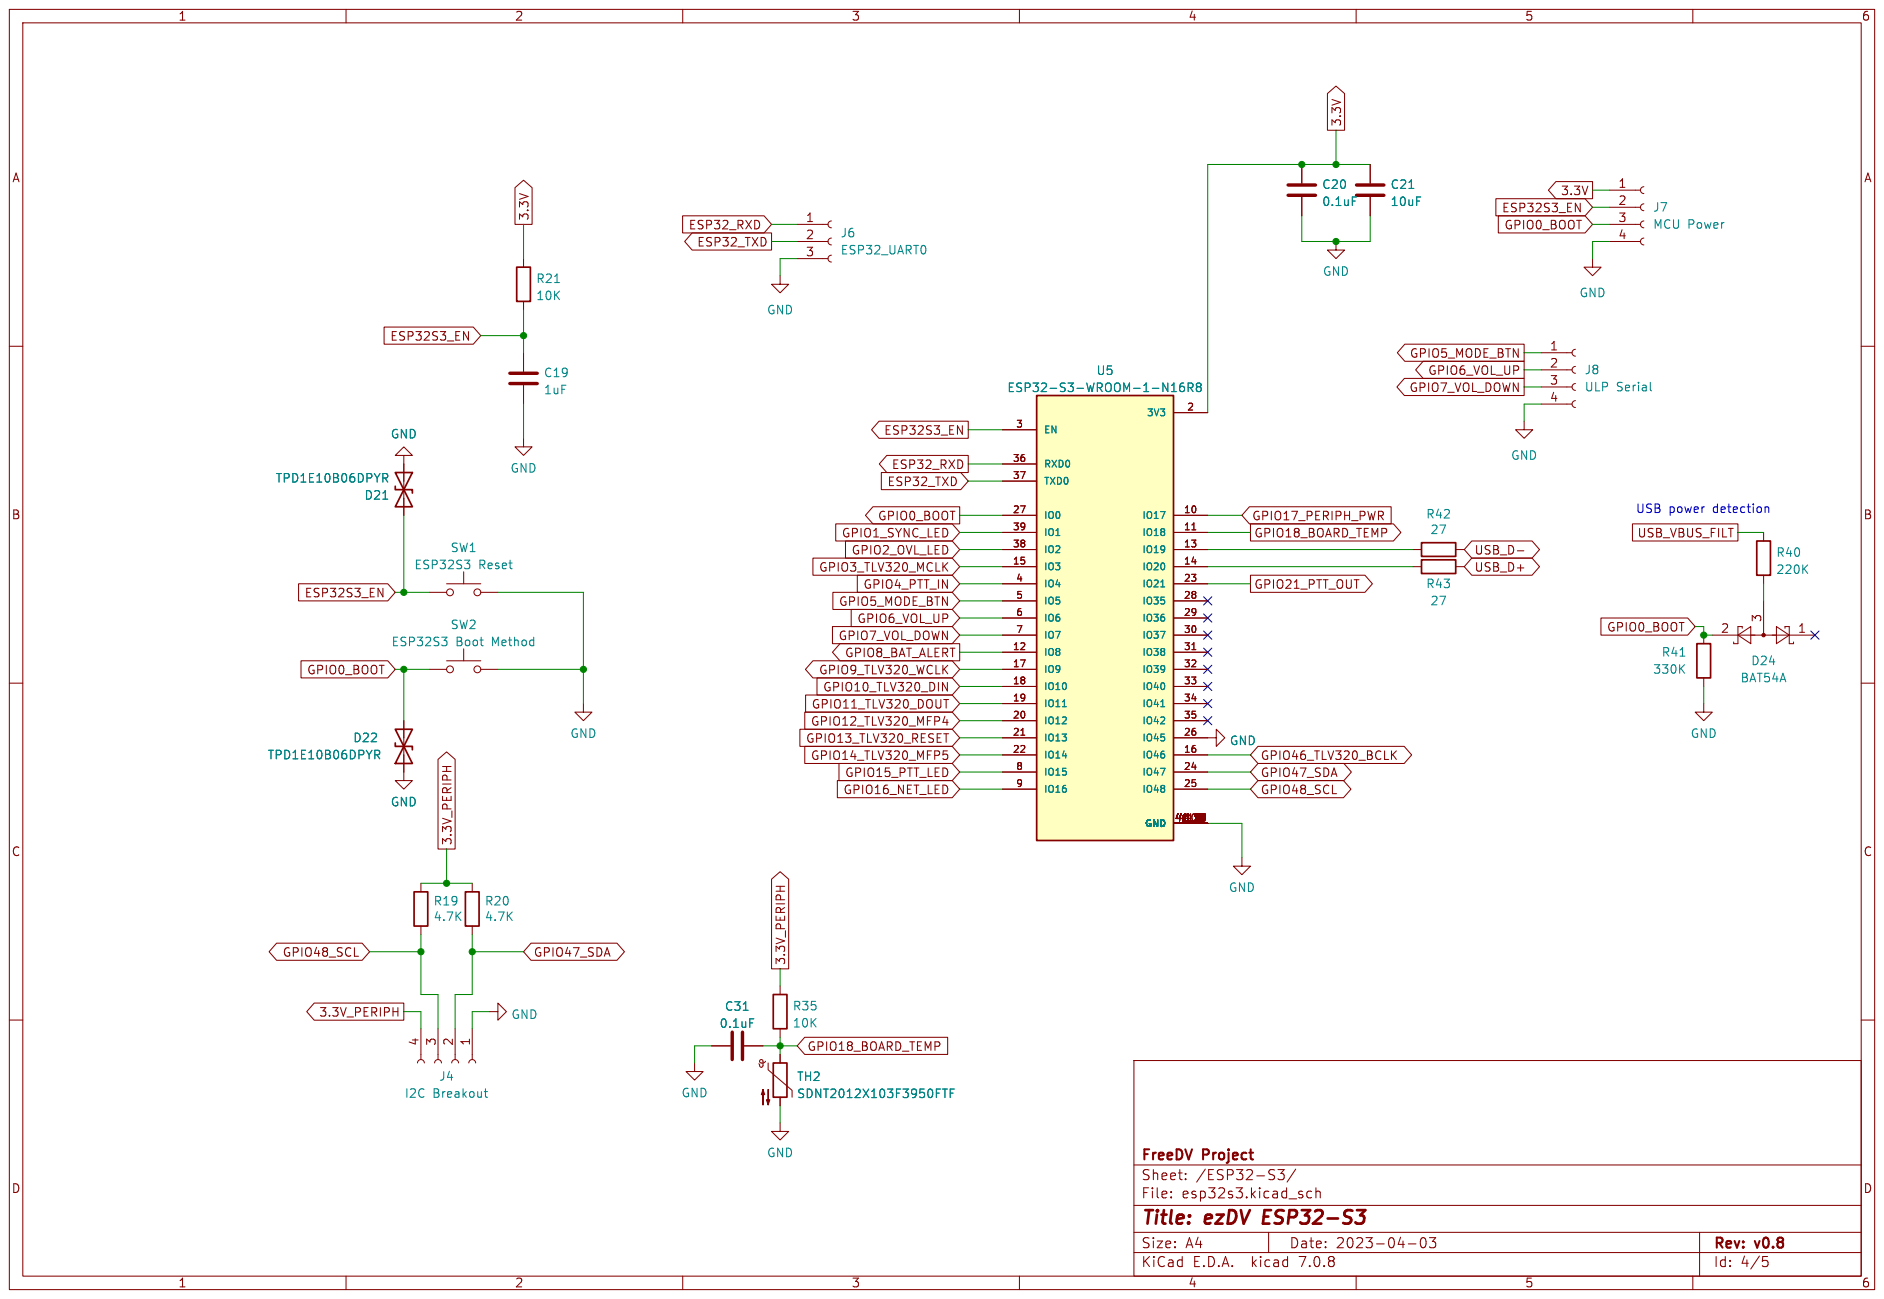
[picture p9: page 4]

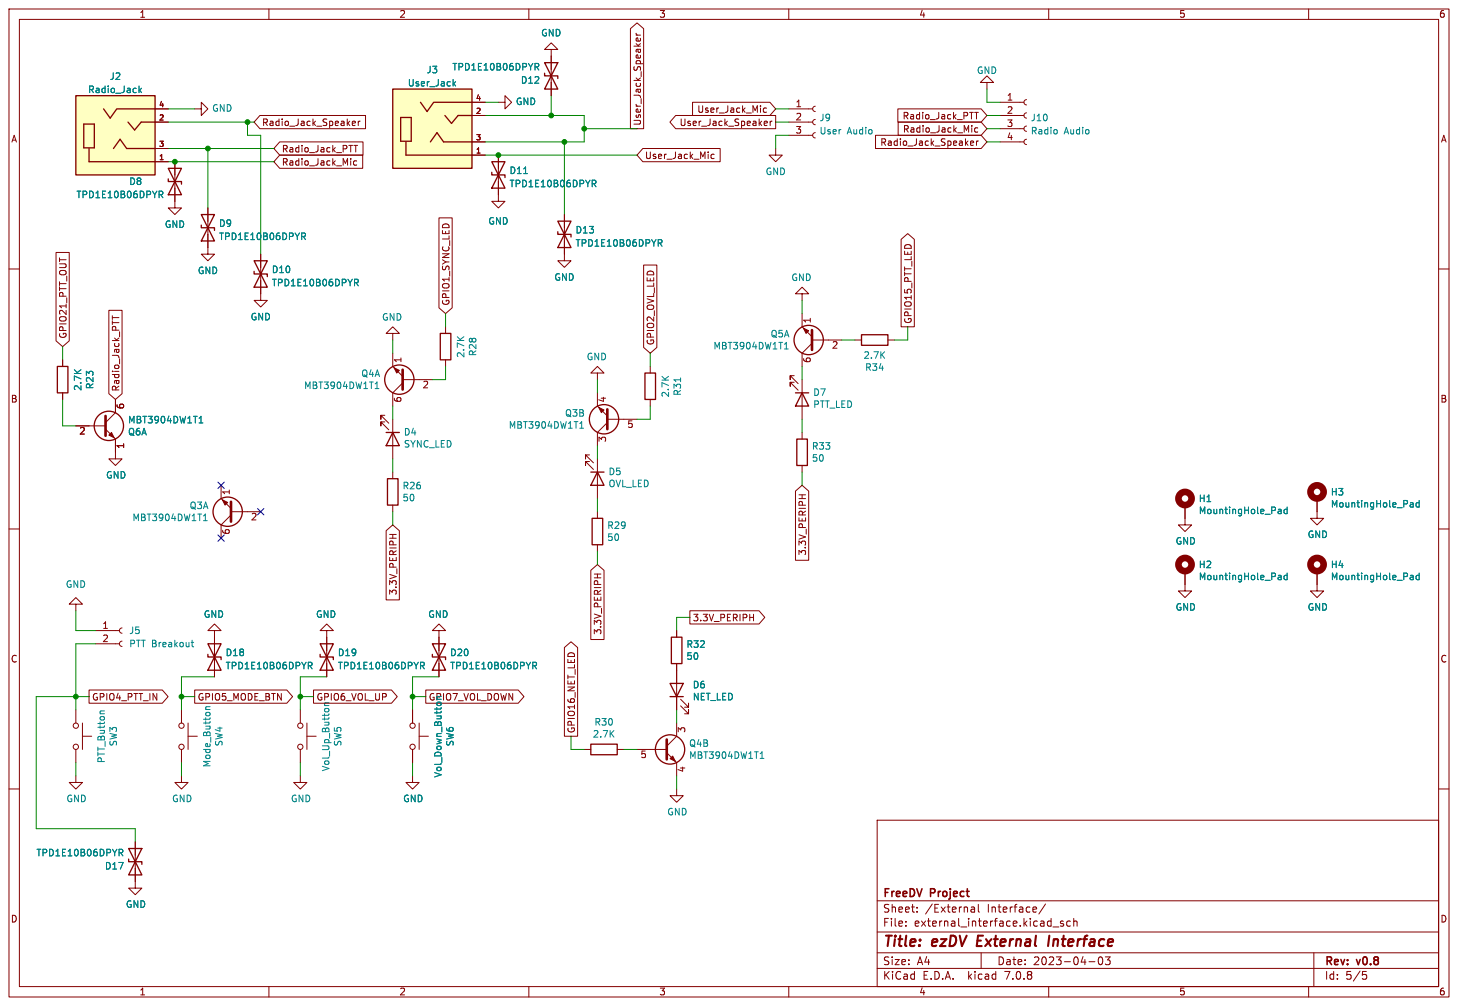
[picture p10: page 5]

J10 Radio Audio GND GND

Id: 5/5 Title: ezDV External Interface
