tmiw/SM1000neo/schematic/v1.0/ezDV.pdf

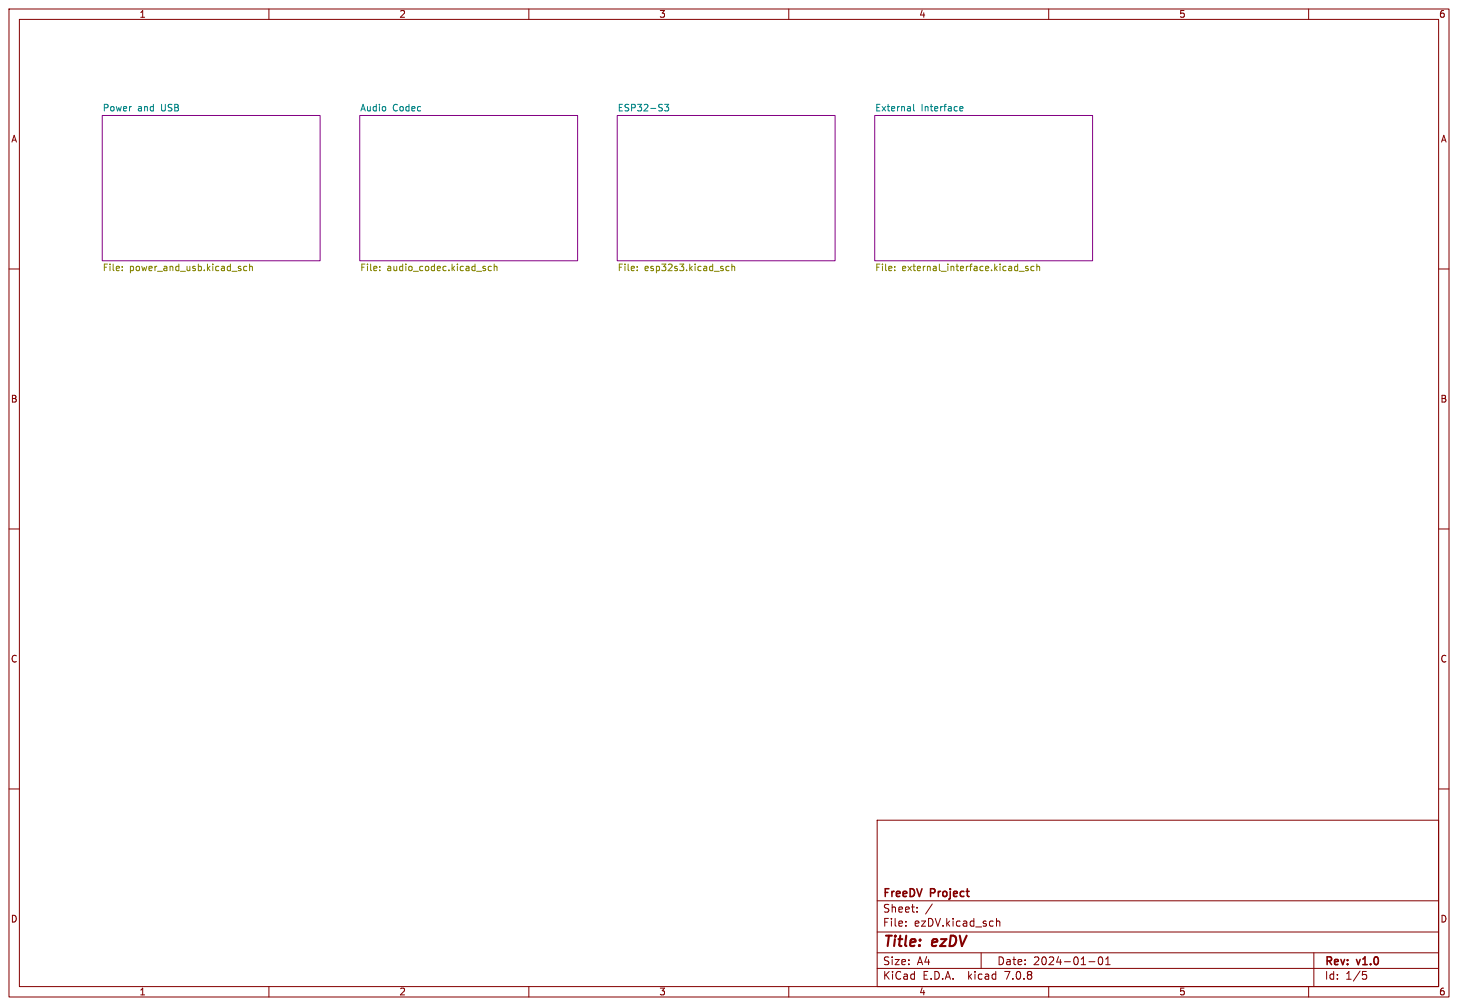
[picture p11: page 1]

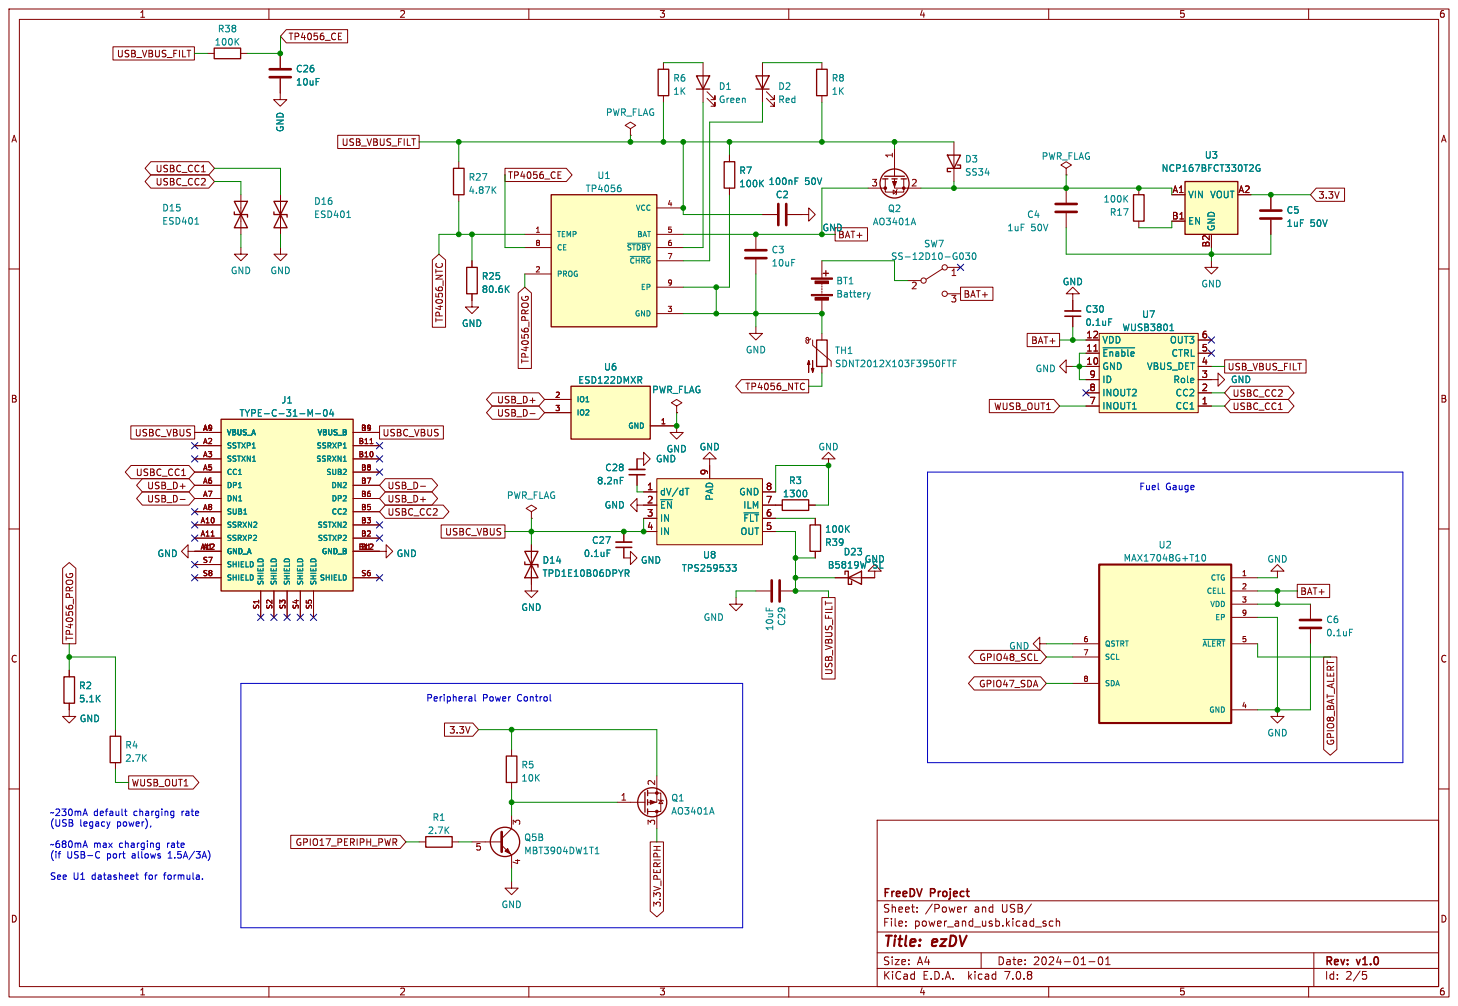
[picture p12: page 2]

9 U8 TPS259533 GND GND GND GND

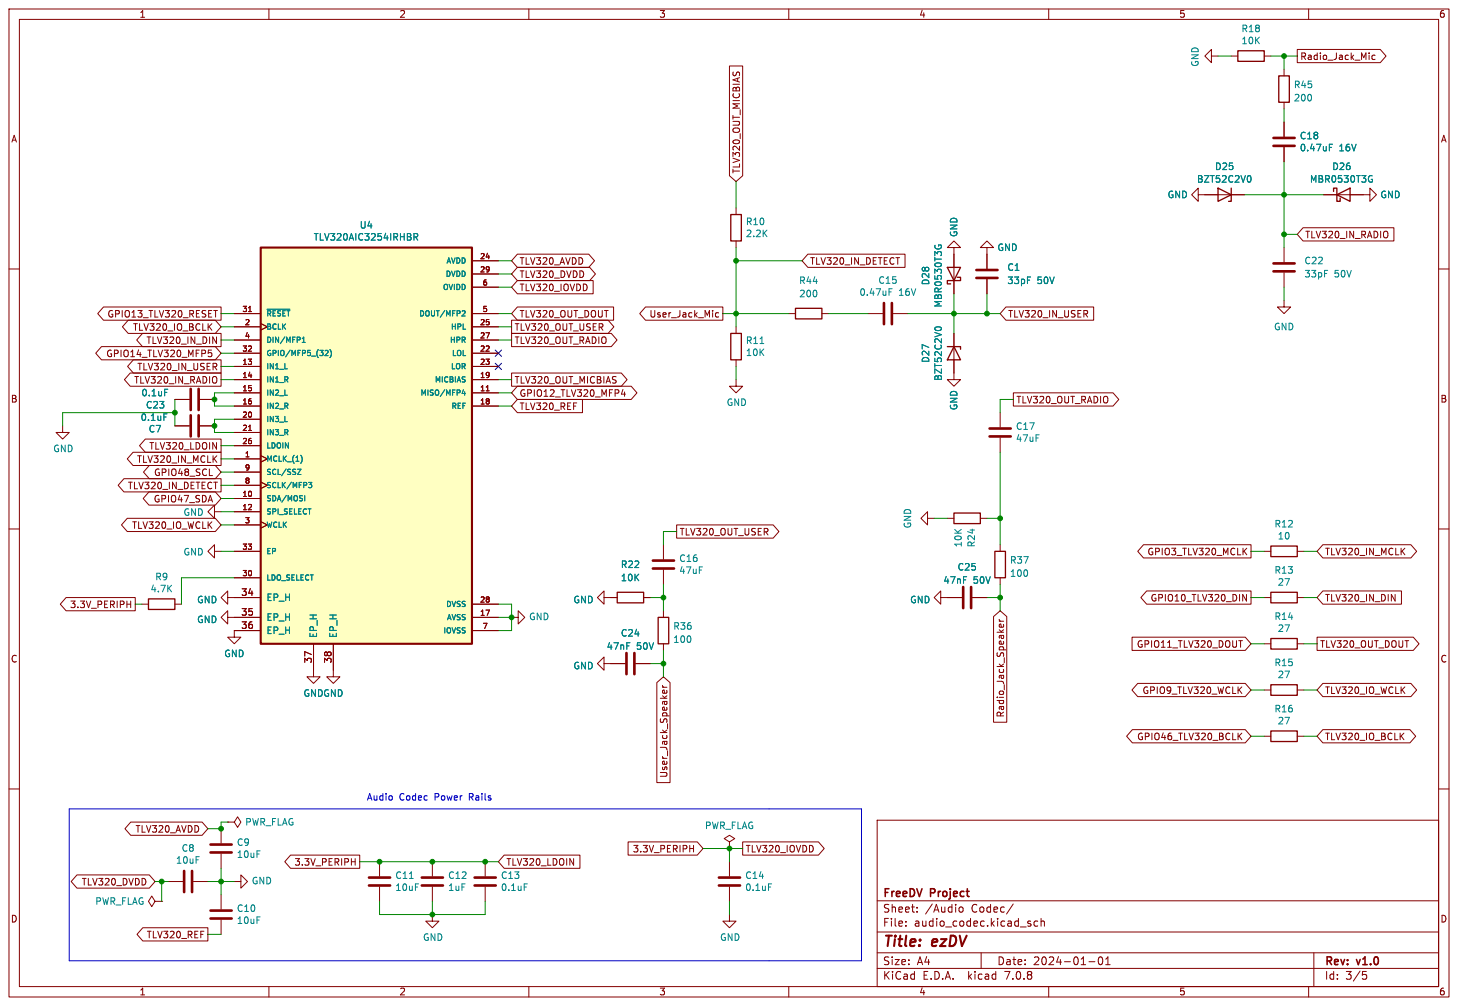
[picture p13: page 3]

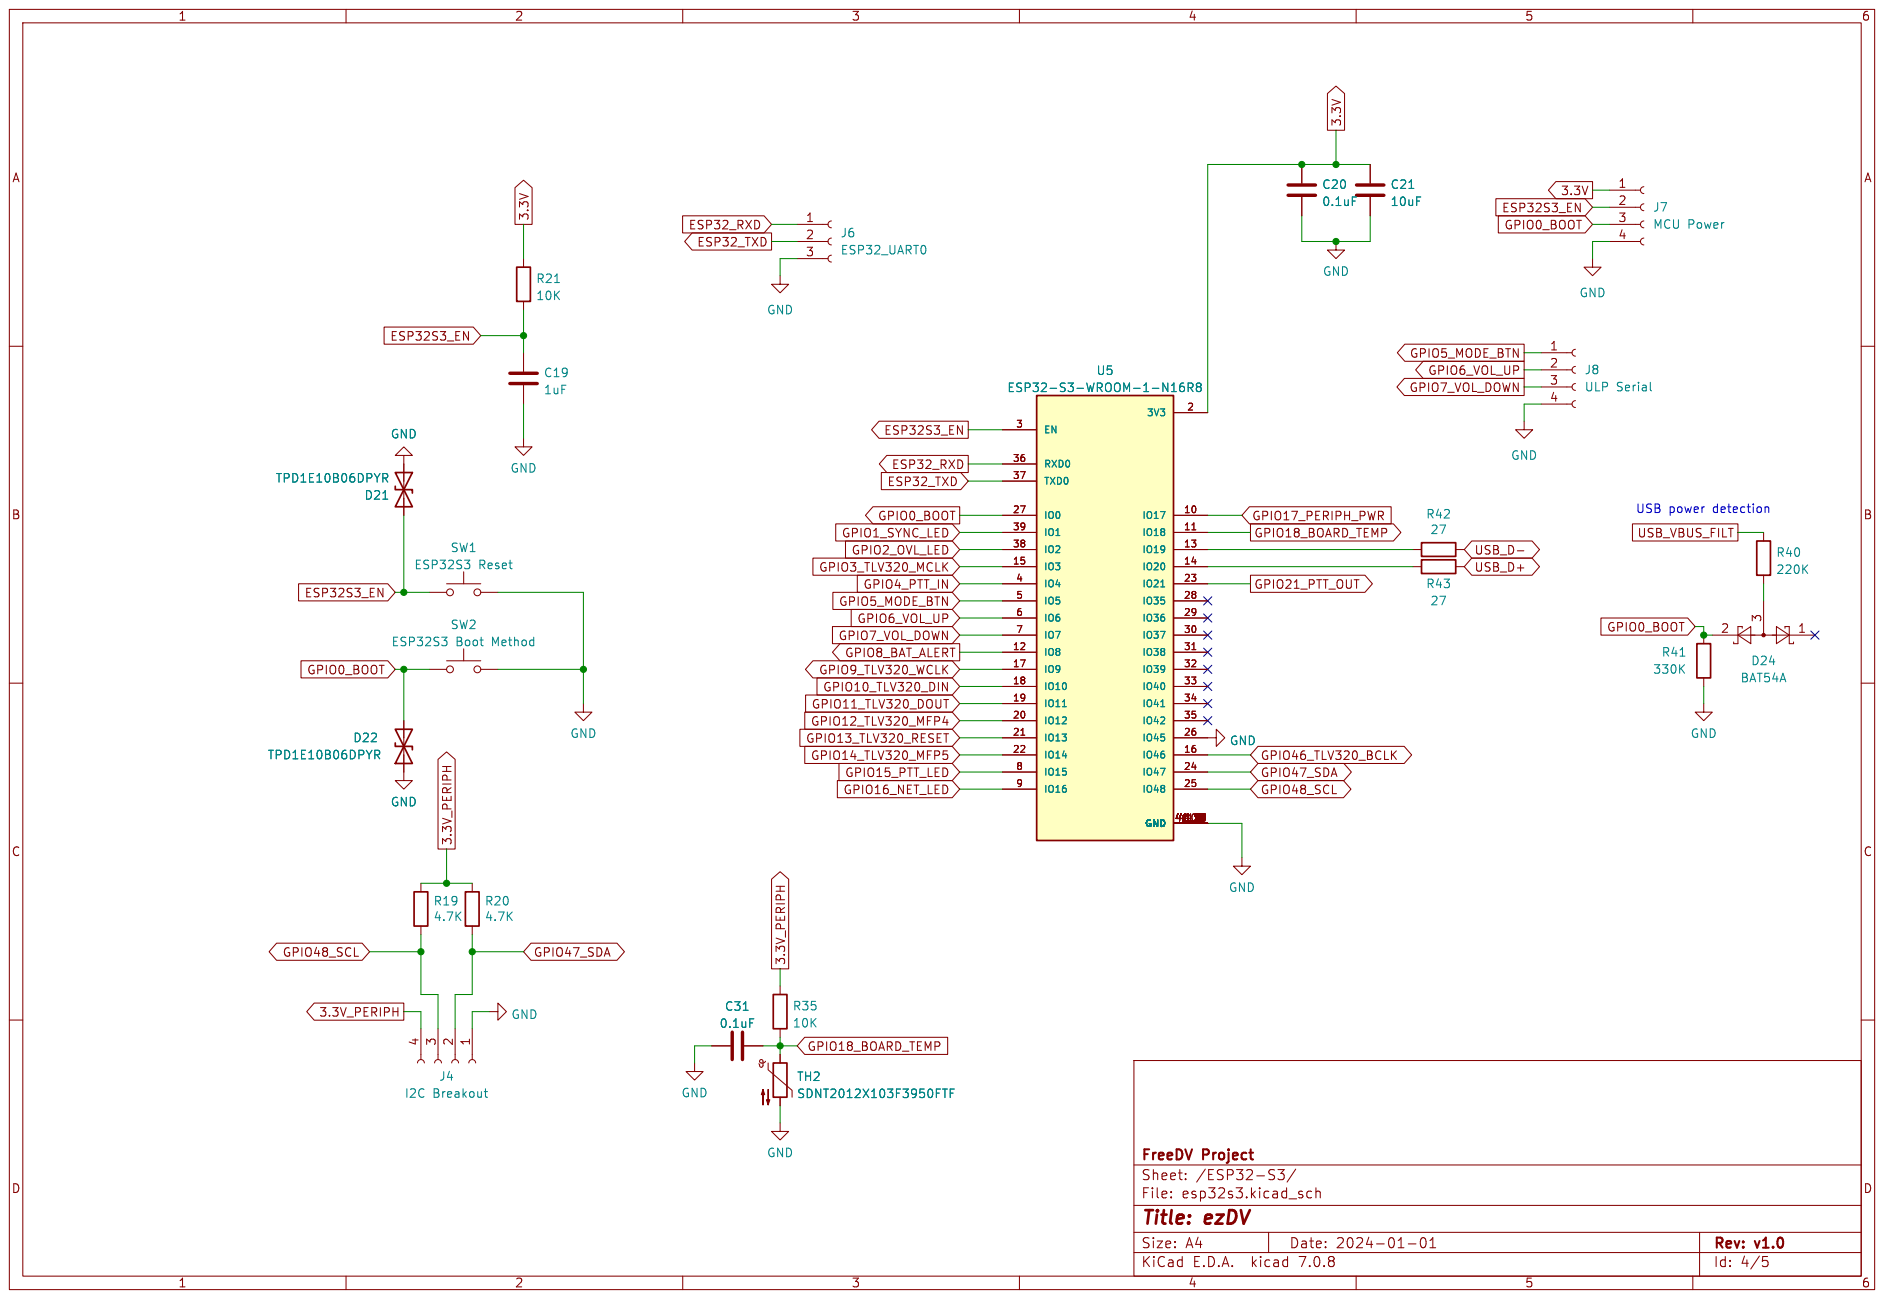
[picture p14: page 4]

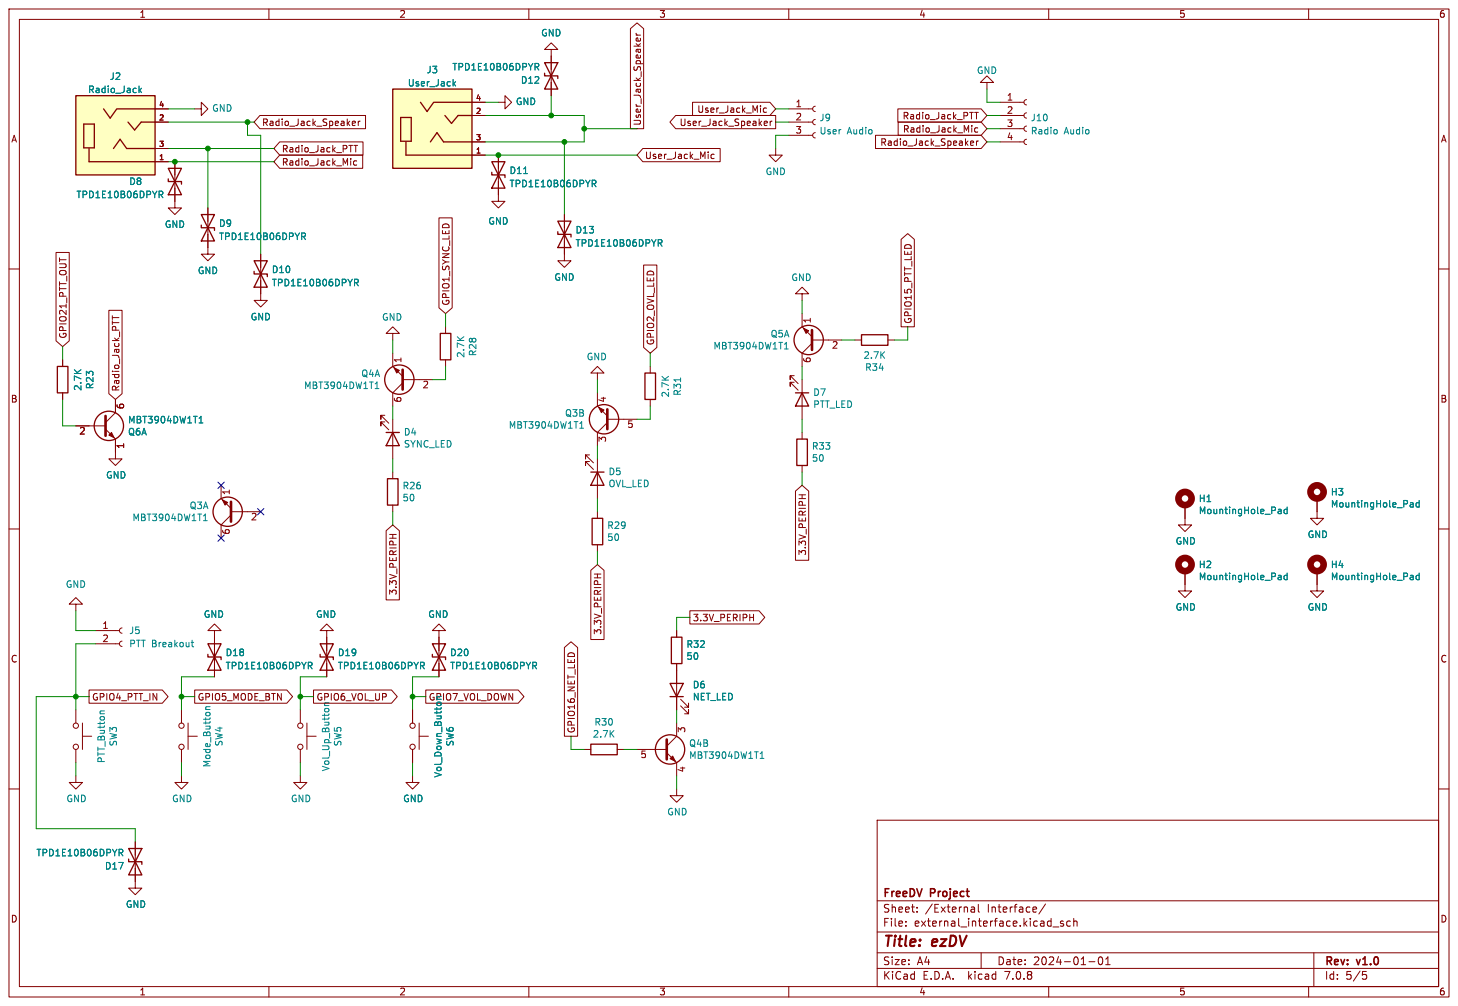
[picture p15: page 5]

J10 Radio Audio GND GND
