tmiw/SM1000neo/schematic/v1.0/ezDV.kicad_pcb

## KiCad design schematic/v1.0/ezDV.kicad_pcb (2024-10-30)

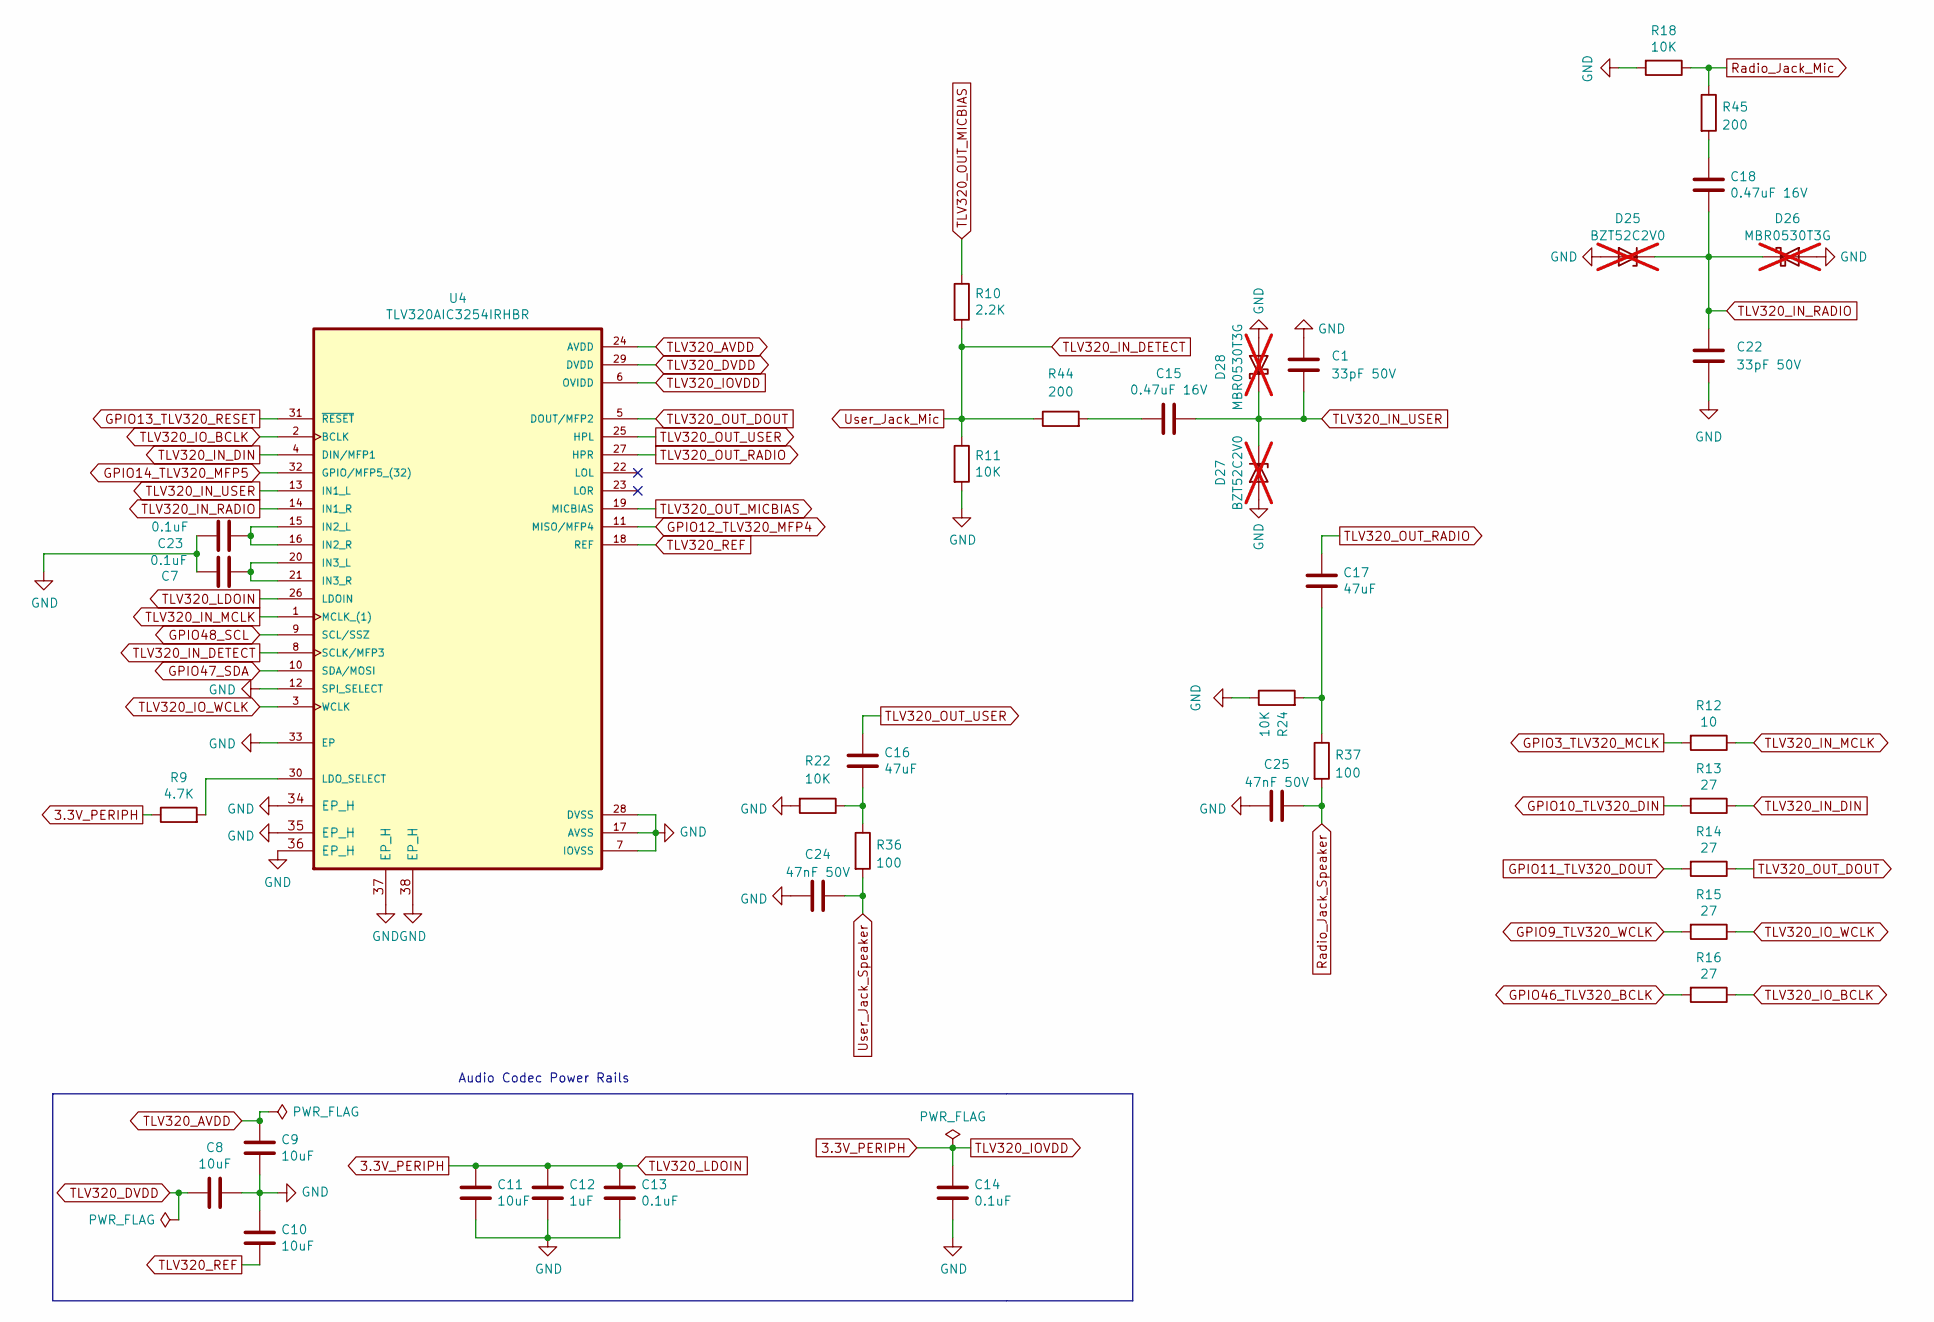
[picture p16: schematic audio_codec.kicad_sch, ezDV]

Parts:
C1, C22: 33pF 50V; C_0402_1005Metric; LCSC C1562
C7, C13, C14, C23: 0.1uF; C_0402_1005Metric; LCSC C1525
C8, C9, C10, C11: 10uF; C_0402_1005Metric; LCSC C15525
C12: 1uF; C_0402_1005Metric; LCSC C52923
C15, C18: 0.47uF 16V; C_0402_1005Metric; LCSC C575468
C16, C17: 47uF; C_0603_1608Metric; LCSC C140782
C24, C25: 47nF 50V; C_0402_1005Metric; LCSC C697422
D25: BZT52C2V0; D_SOD-123; LCSC_DNP C2891405; not fitted
D26: MBR0530T3G; D_SOD-123; LCSC_DNP C236079; not fitted
D27: BZT52C2V0; D_SOD-123; LCSC C2891405; not fitted
D28: MBR0530T3G; D_SOD-123; LCSC C236079; not fitted
R9: 4.7K; R_0402_1005Metric; LCSC C25900
R10: 2.2K; R_0402_1005Metric; LCSC C25879
R11, R18, R22, R24: 10K; R_0402_1005Metric; LCSC C25744
R12: 10; R_0402_1005Metric; LCSC C25077
R13, R14, R15, R16: 27; R_0402_1005Metric; LCSC C25100
R36, R37: 100; R_0402_1005Metric; LCSC C25076
R44, R45: 200; R_0402_1005Metric; LCSC C25087
U4: TLV320AIC3254IRHBR; IC_ADS125H01IRHBT; LCSC C9925

Connections:
3.3V_PERIPH: C11.1, C12.1, C13.1, C14.1, R9.1, U4.6 (OVIDD), U4.26 (LDOIN); also elsewhere on the board
GND: C1.1, C7.2, C8.1, C9.2, C10.1, C11.2, C12.2, C13.2, C14.2, C22.2, C23.2, C24.1, C25.1, D25.2 (A), D26.2 (A), D27.2 (A), D28.2 (A), R11.2, R18.2, R22.2, R24.1, U4.7 (IOVSS), U4.12 (SPI_SELECT), U4.17 (AVSS), U4.28 (DVSS), U4.33 (EP), U4.34 (EP_H), U4.35 (EP_H), U4.36 (EP_H), U4.37 (EP_H), U4.38 (EP_H); also elsewhere on the board
GPIO3_TLV320_MCLK: R12.2; also elsewhere on the board
GPIO9_TLV320_WCLK: R15.2; also elsewhere on the board
GPIO10_TLV320_DIN: R13.2; also elsewhere on the board
GPIO11_TLV320_DOUT: R14.2; also elsewhere on the board
GPIO12_TLV320_MFP4: U4.11 (MISO/MFP4); also elsewhere on the board
GPIO13_TLV320_RESET: U4.31 (~RESET); also elsewhere on the board
GPIO14_TLV320_MFP5: U4.32 (GPIO/MFP5_(32)); also elsewhere on the board
GPIO46_TLV320_BCLK: R16.2; also elsewhere on the board
GPIO47_SDA: U4.10 (SDA/MOSI); also elsewhere on the board
GPIO48_SCL: U4.9 (SCL/SSZ); also elsewhere on the board
unnamed: C15.1, R44.2
unnamed: C16.2, R22.1, R36.1
unnamed: C17.2, R24.2, R37.1
unnamed: C18.1, R45.2
unnamed: C7.1, U4.15 (IN2_L), U4.16 (IN2_R)
unnamed: C23.1, U4.20 (IN3_L), U4.21 (IN3_R)
unnamed: R9.2, U4.30 (LDO_SELECT)
Radio_Jack_Mic: R18.1, R45.1; also elsewhere on the board
Radio_Jack_Speaker: C25.2, R37.2; also elsewhere on the board
TLV320_AVDD: C9.1, U4.24 (AVDD)
TLV320_DVDD: C8.2, U4.29 (DVDD)
TLV320_IN_DETECT: R10.2, R11.1, R44.1, U4.8 (SCLK/MFP3); also elsewhere on the board
TLV320_IN_DIN: R13.1, U4.4 (DIN/MFP1)
TLV320_IN_MCLK: R12.1, U4.1 (MCLK_(1))
TLV320_IN_RADIO: C18.2, C22.1, D25.1 (K), D26.1 (K), U4.14 (IN1_R)
TLV320_IN_USER: C1.2, C15.2, D27.1 (K), D28.1 (K), U4.13 (IN1_L)
TLV320_IO_BCLK: R16.1, U4.2 (BCLK)
TLV320_IO_WCLK: R15.1, U4.3 (WCLK)
TLV320_OUT_DOUT: R14.1, U4.5 (DOUT/MFP2)
TLV320_OUT_MICBIAS: R10.1, U4.19 (MICBIAS)
TLV320_OUT_RADIO: C17.1, U4.27 (HPR)
TLV320_OUT_USER: C16.1, U4.25 (HPL)
TLV320_REF: C10.2, U4.18 (REF)
User_Jack_Speaker: C24.2, R36.2; also elsewhere on the board

Notes on the sheet:
Audio Codec Power Rails

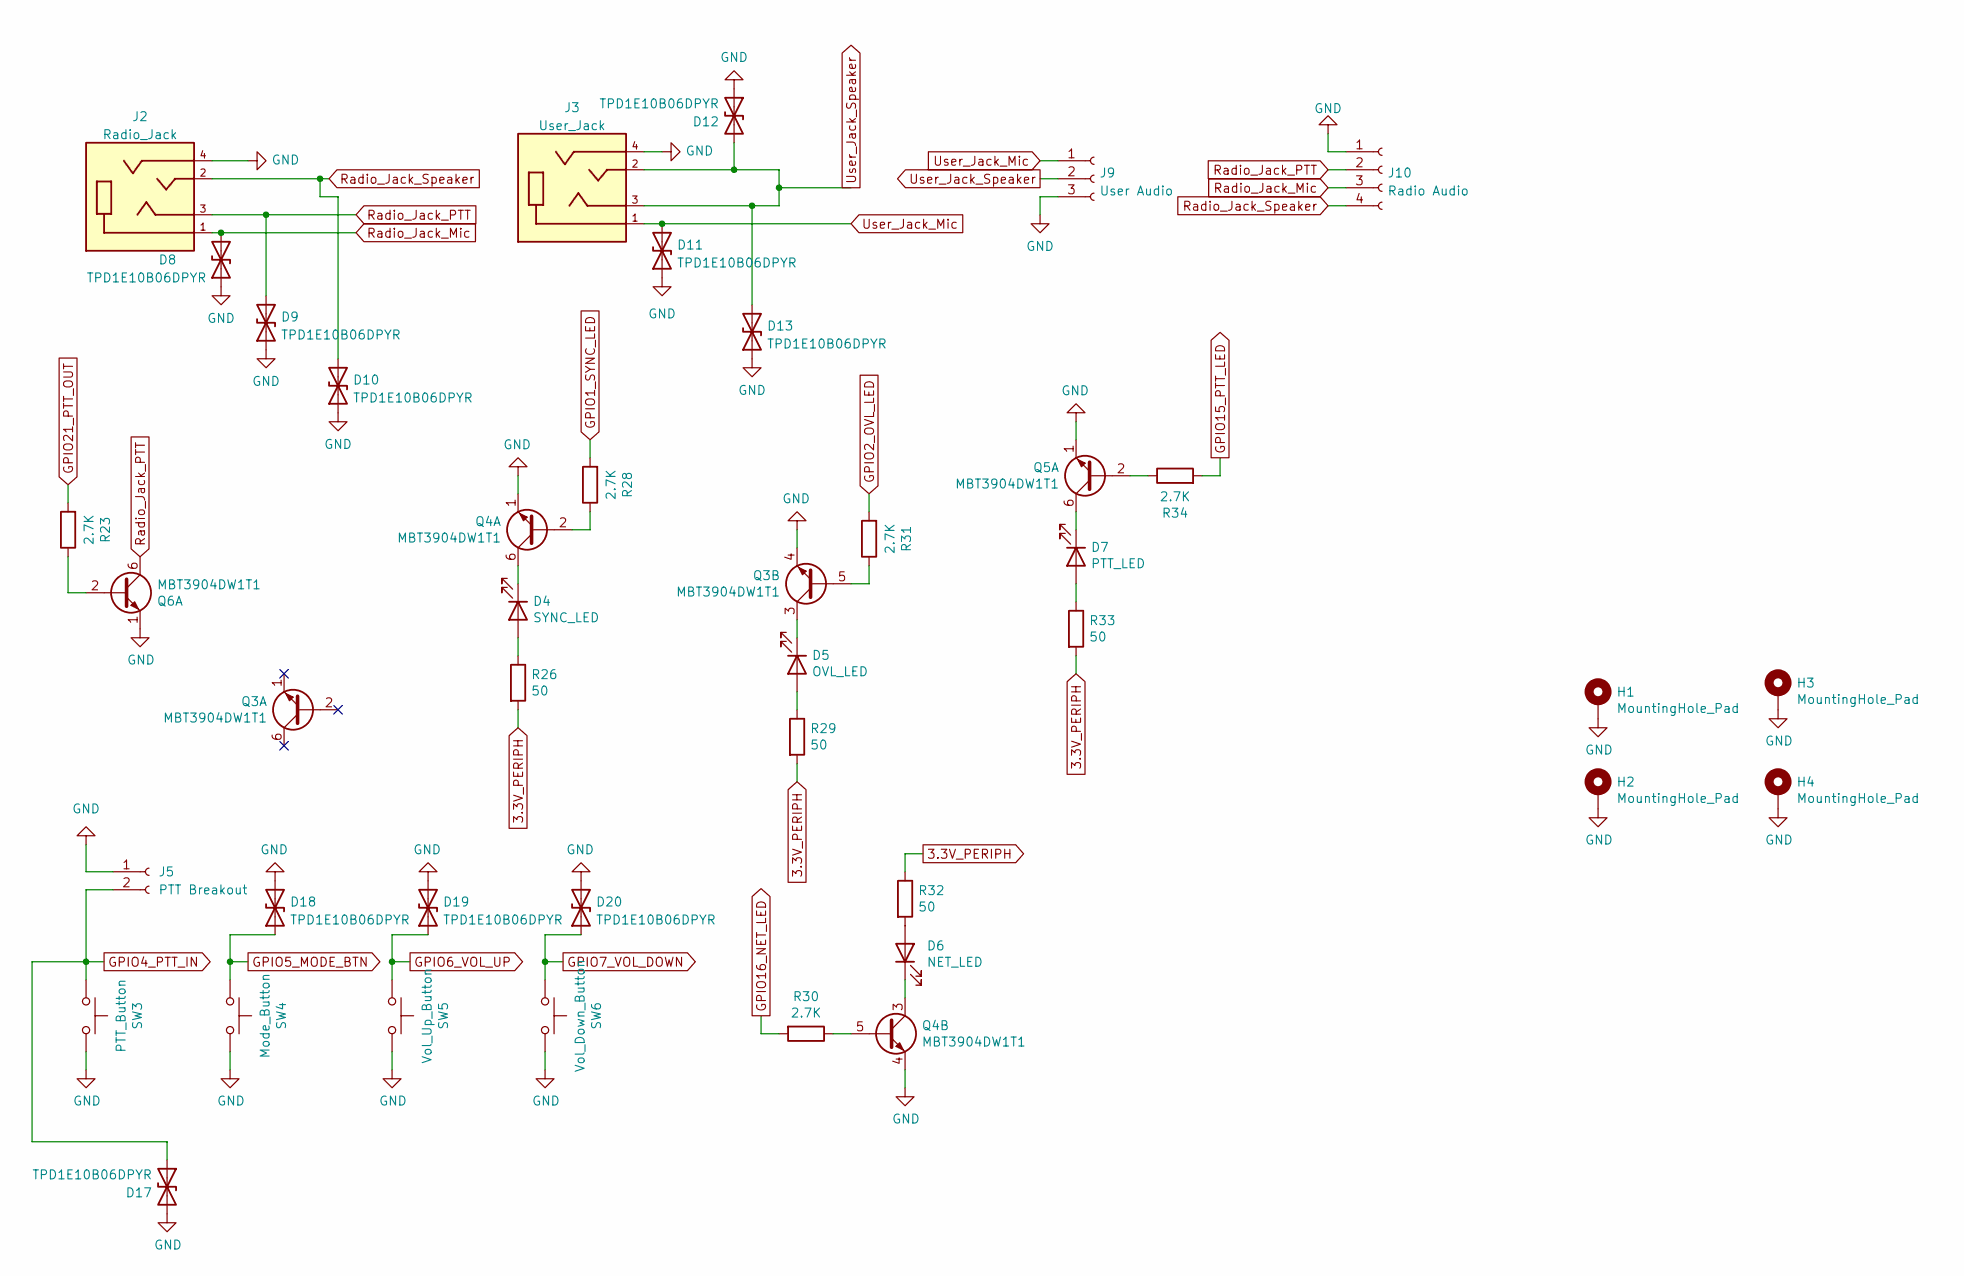
[picture p17: schematic external_interface.kicad_sch, ezDV]

Parts:
D4: SYNC_LED; D_0603_1608Metric; LCSC C965805
D5: OVL_LED; D_0603_1608Metric; LCSC C2286
D6: NET_LED; D_0603_1608Metric; LCSC C72041
D7: PTT_LED; D_0603_1608Metric; LCSC C2286
D8, D9, D10, D11, D12, D13, D17, D18, D19, D20: TPD1E10B06DPYR; DIO_TPD1E05U06DPYR; LCSC C48260
H1, H2, H3, H4: MountingHole_Pad; MountingHole_3.2mm_M3_Pad; JLCPCB_Basic N/A
J2: Radio_Jack; TRRS-PJ-320A; LCSC C2884926
J3: User_Jack; TRRS-PJ-320A; LCSC C2884926
J5: PTT Breakout; PinHeader_1x02_P2.54mm_Vertical; JLCPCB_Basic N/A
J9: User Audio; PinSocket_1x03_P2.54mm_Vertical; JLCPCB_Basic N/A
J10: Radio Audio; PinHeader_1x04_P2.54mm_Vertical; JLCPCB_Basic N/A
Q3, Q4, Q5, Q6: MBT3904DW1T1; SOT-363_SC-70-6; LCSC C110150
R23, R28, R30, R31, R34: 2.7K; R_0603_1608Metric; LCSC C13167
R26, R29, R32, R33: 50; R_0603_1608Metric; LCSC C22808
SW3: PTT_Button; SW_PUSH_6mm_H4.3mm; LCSC C2837517
SW4: Mode_Button; SW_PUSH_6mm_H4.3mm; LCSC C2837517
SW5: Vol_Up_Button; SW_PUSH_6mm_H4.3mm; LCSC C2837517
SW6: Vol_Down_Button; SW_PUSH_6mm_H4.3mm; LCSC C2837517

Connections:
3.3V_PERIPH: R26.2, R29.2, R32.1, R33.2; also elsewhere on the board
GND: D8.1 (A1), D9.1 (A1), D10.1 (A1), D11.1 (A1), D12.1 (A1), D13.1 (A1), D17.2 (A2), D18.2 (A2), D19.2 (A2), D20.2 (A2), H1.1, H2.1, H3.1, H4.1, J2.4, J3.4, J5.1, J9.3, J10.1, Q3.4 (E2), Q4.1 (E1), Q4.4 (E2), Q5.1 (E1), Q6.1 (E1), SW3.2, SW4.2, SW5.2, SW6.2; also elsewhere on the board
GPIO1_SYNC_LED: R28.2; also elsewhere on the board
GPIO2_OVL_LED: R31.2; also elsewhere on the board
GPIO4_PTT_IN: D17.1 (A1), J5.2, SW3.1; also elsewhere on the board
GPIO5_MODE_BTN: D18.1 (A1), SW4.1; also elsewhere on the board
GPIO6_VOL_UP: D19.1 (A1), SW5.1; also elsewhere on the board
GPIO7_VOL_DOWN: D20.1 (A1), SW6.1; also elsewhere on the board
GPIO15_PTT_LED: R34.2; also elsewhere on the board
GPIO16_NET_LED: R30.2; also elsewhere on the board
GPIO21_PTT_OUT: R23.2; also elsewhere on the board
unnamed: D4.2 (A), R26.1
unnamed: D4.1 (K), Q4.6 (C1)
unnamed: D5.2 (A), R29.1
unnamed: D5.1 (K), Q3.3 (C2)
unnamed: D6.2 (A), R32.2
unnamed: D6.1 (K), Q4.3 (C2)
unnamed: D7.2 (A), R33.1
unnamed: D7.1 (K), Q5.6 (C1)
unnamed: Q3.5 (B2), R31.1
unnamed: Q4.2 (B1), R28.1
unnamed: Q4.5 (B2), R30.1
unnamed: Q5.2 (B1), R34.1
unnamed: Q6.2 (B1), R23.1
Radio_Jack_Mic: D8.2 (A2), J2.1, J10.3; also elsewhere on the board
Radio_Jack_PTT: D9.2 (A2), J2.3, J10.2, Q6.6 (C1)
Radio_Jack_Speaker: D10.2 (A2), J2.2, J10.4; also elsewhere on the board
TLV320_IN_DETECT: D11.2 (A2), J3.1, J9.1; also elsewhere on the board
User_Jack_Speaker: D12.2 (A2), D13.2 (A2), J3.2, J3.3, J9.2; also elsewhere on the board

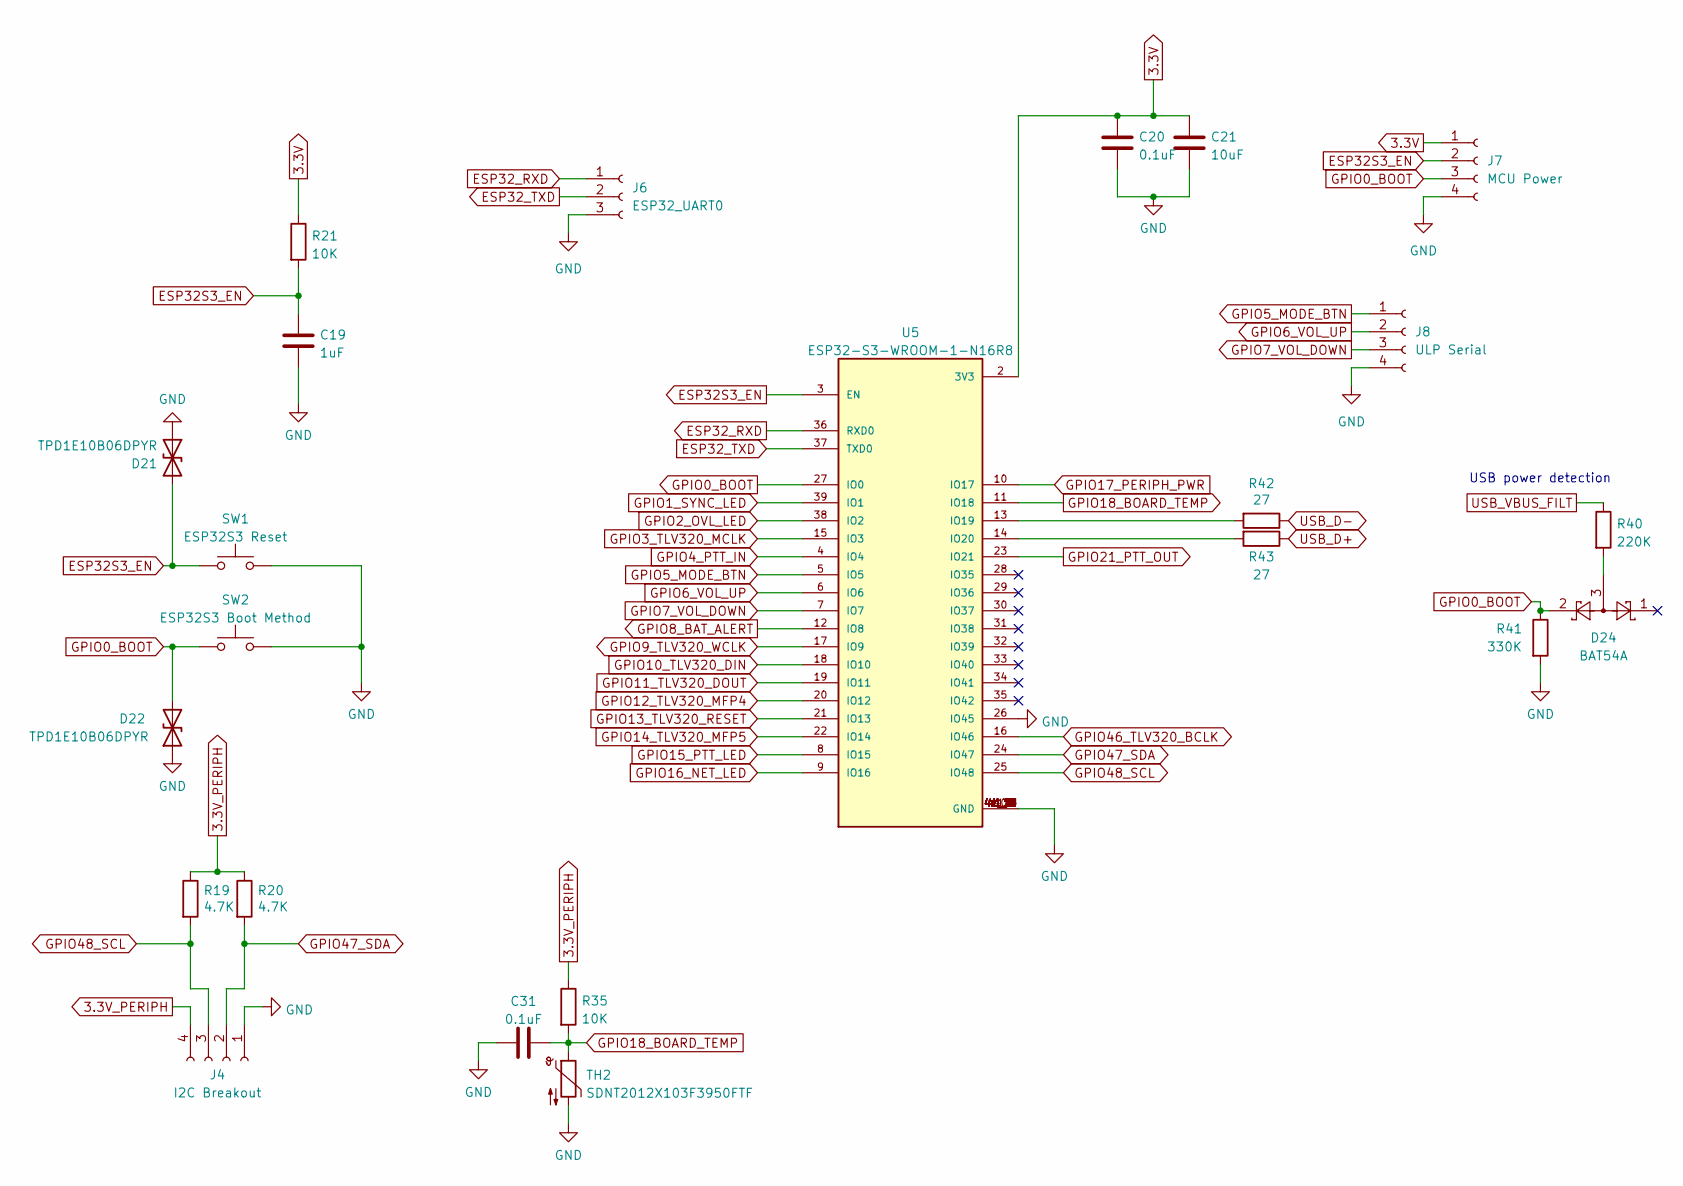
[picture p18: schematic esp32s3.kicad_sch, ezDV]

Parts:
C19: 1uF; C_0402_1005Metric; LCSC C52923
C20, C31: 0.1uF; C_0402_1005Metric; LCSC C1525
C21: 10uF; C_0402_1005Metric; LCSC C15525
D21, D22: TPD1E10B06DPYR; DIO_TPD1E05U06DPYR; LCSC C48260
D24: BAT54A; SOT-23; LCSC C134401
J4: I2C Breakout; PinHeader_2x02_P2.54mm_Vertical; JLCPCB_Basic N/A
J6: ESP32_UART0; PinHeader_1x03_P2.54mm_Vertical; JLCPCB_Basic N/A
J7: MCU Power; PinHeader_1x04_P2.54mm_Vertical; JLCPCB_Basic N/A
J8: ULP Serial; PinHeader_2x02_P2.54mm_Vertical; JLCPCB_Basic N/A
R19, R20: 4.7K; R_0603_1608Metric; LCSC C23162
R21, R35: 10K; R_0402_1005Metric; LCSC C25744
R40: 220K; R_0402_1005Metric; LCSC C25767
R41: 330K; R_0402_1005Metric; LCSC C25778
R42, R43: 27; R_0402_1005Metric; LCSC C25100
SW1: ESP32S3 Reset; SW_PUSH_6mm_H4.3mm; LCSC C2837514
SW2: ESP32S3 Boot Method; SW_PUSH_6mm_H4.3mm; LCSC C2837514
TH2: SDNT2012X103F3950FTF; R_0805_2012Metric; LCSC C95968
U5: ESP32-S3-WROOM-1-N16R8; XCVR_ESP32S3WROOM1N8R8; LCSC C2913202

Connections:
3.3V: C20.1, C21.1, J7.1, R21.1, U5.2 (3V3); also elsewhere on the board
3.3V_PERIPH: J4.4, R19.1, R20.1, R35.1; also elsewhere on the board
ESP32S3_EN: C19.1, D21.2 (A2), J7.2, R21.2, SW1.1, U5.3 (EN)
ESP32_RXD: J6.1, U5.36 (RXD0)
ESP32_TXD: J6.2, U5.37 (TXD0)
GND: C19.2, C20.2, C21.2, C31.1, D21.1 (A1), D22.1 (A1), J4.1, J6.3, J7.4, J8.4, R41.2, SW1.2, SW2.2, TH2.2, U5.1 (GND), U5.26 (IO45), U5.40 (GND), U5.41_1 (GND), U5.41_2 (GND), U5.41_3 (GND), U5.41_4 (GND), U5.41_5 (GND), U5.41_6 (GND), U5.41_7 (GND), U5.41_8 (GND), U5.41_9 (GND), U5.41_10 (GND), U5.41_11 (GND), U5.41_12 (GND), U5.41_13 (GND), U5.41_14 (GND), U5.41_15 (GND), U5.41_16 (GND), U5.41_17 (GND), U5.41_18 (GND), U5.41_19 (GND), U5.41_20 (GND), U5.41_21 (GND); also elsewhere on the board
GPIO0_BOOT: D22.2 (A2), D24.2, J7.3, R41.1, SW2.1, U5.27 (IO0)
GPIO1_SYNC_LED: U5.39 (IO1); also elsewhere on the board
GPIO2_OVL_LED: U5.38 (IO2); also elsewhere on the board
GPIO3_TLV320_MCLK: U5.15 (IO3); also elsewhere on the board
GPIO4_PTT_IN: U5.4 (IO4); also elsewhere on the board
GPIO5_MODE_BTN: J8.1, U5.5 (IO5); also elsewhere on the board
GPIO6_VOL_UP: J8.2, U5.6 (IO6); also elsewhere on the board
GPIO7_VOL_DOWN: J8.3, U5.7 (IO7); also elsewhere on the board
GPIO8_BAT_ALERT: U5.12 (IO8); also elsewhere on the board
GPIO9_TLV320_WCLK: U5.17 (IO9); also elsewhere on the board
GPIO10_TLV320_DIN: U5.18 (IO10); also elsewhere on the board
GPIO11_TLV320_DOUT: U5.19 (IO11); also elsewhere on the board
GPIO12_TLV320_MFP4: U5.20 (IO12); also elsewhere on the board
GPIO13_TLV320_RESET: U5.21 (IO13); also elsewhere on the board
GPIO14_TLV320_MFP5: U5.22 (IO14); also elsewhere on the board
GPIO15_PTT_LED: U5.8 (IO15); also elsewhere on the board
GPIO16_NET_LED: U5.9 (IO16); also elsewhere on the board
GPIO17_PERIPH_PWR: U5.10 (IO17); also elsewhere on the board
GPIO18_BOARD_TEMP: C31.2, R35.2, TH2.1, U5.11 (IO18)
GPIO21_PTT_OUT: U5.23 (IO21); also elsewhere on the board
GPIO46_TLV320_BCLK: U5.16 (IO46); also elsewhere on the board
GPIO47_SDA: J4.2, R20.2, U5.24 (IO47); also elsewhere on the board
GPIO48_SCL: J4.3, R19.2, U5.25 (IO48); also elsewhere on the board
unnamed: D24.3, R40.2
unnamed: R42.2, U5.13 (IO19)
unnamed: R43.2, U5.14 (IO20)
USB_D+: R43.1; also elsewhere on the board
USB_D-: R42.1; also elsewhere on the board
USB_VBUS_FILT: R40.1; also elsewhere on the board

Notes on the sheet:
USB power detection

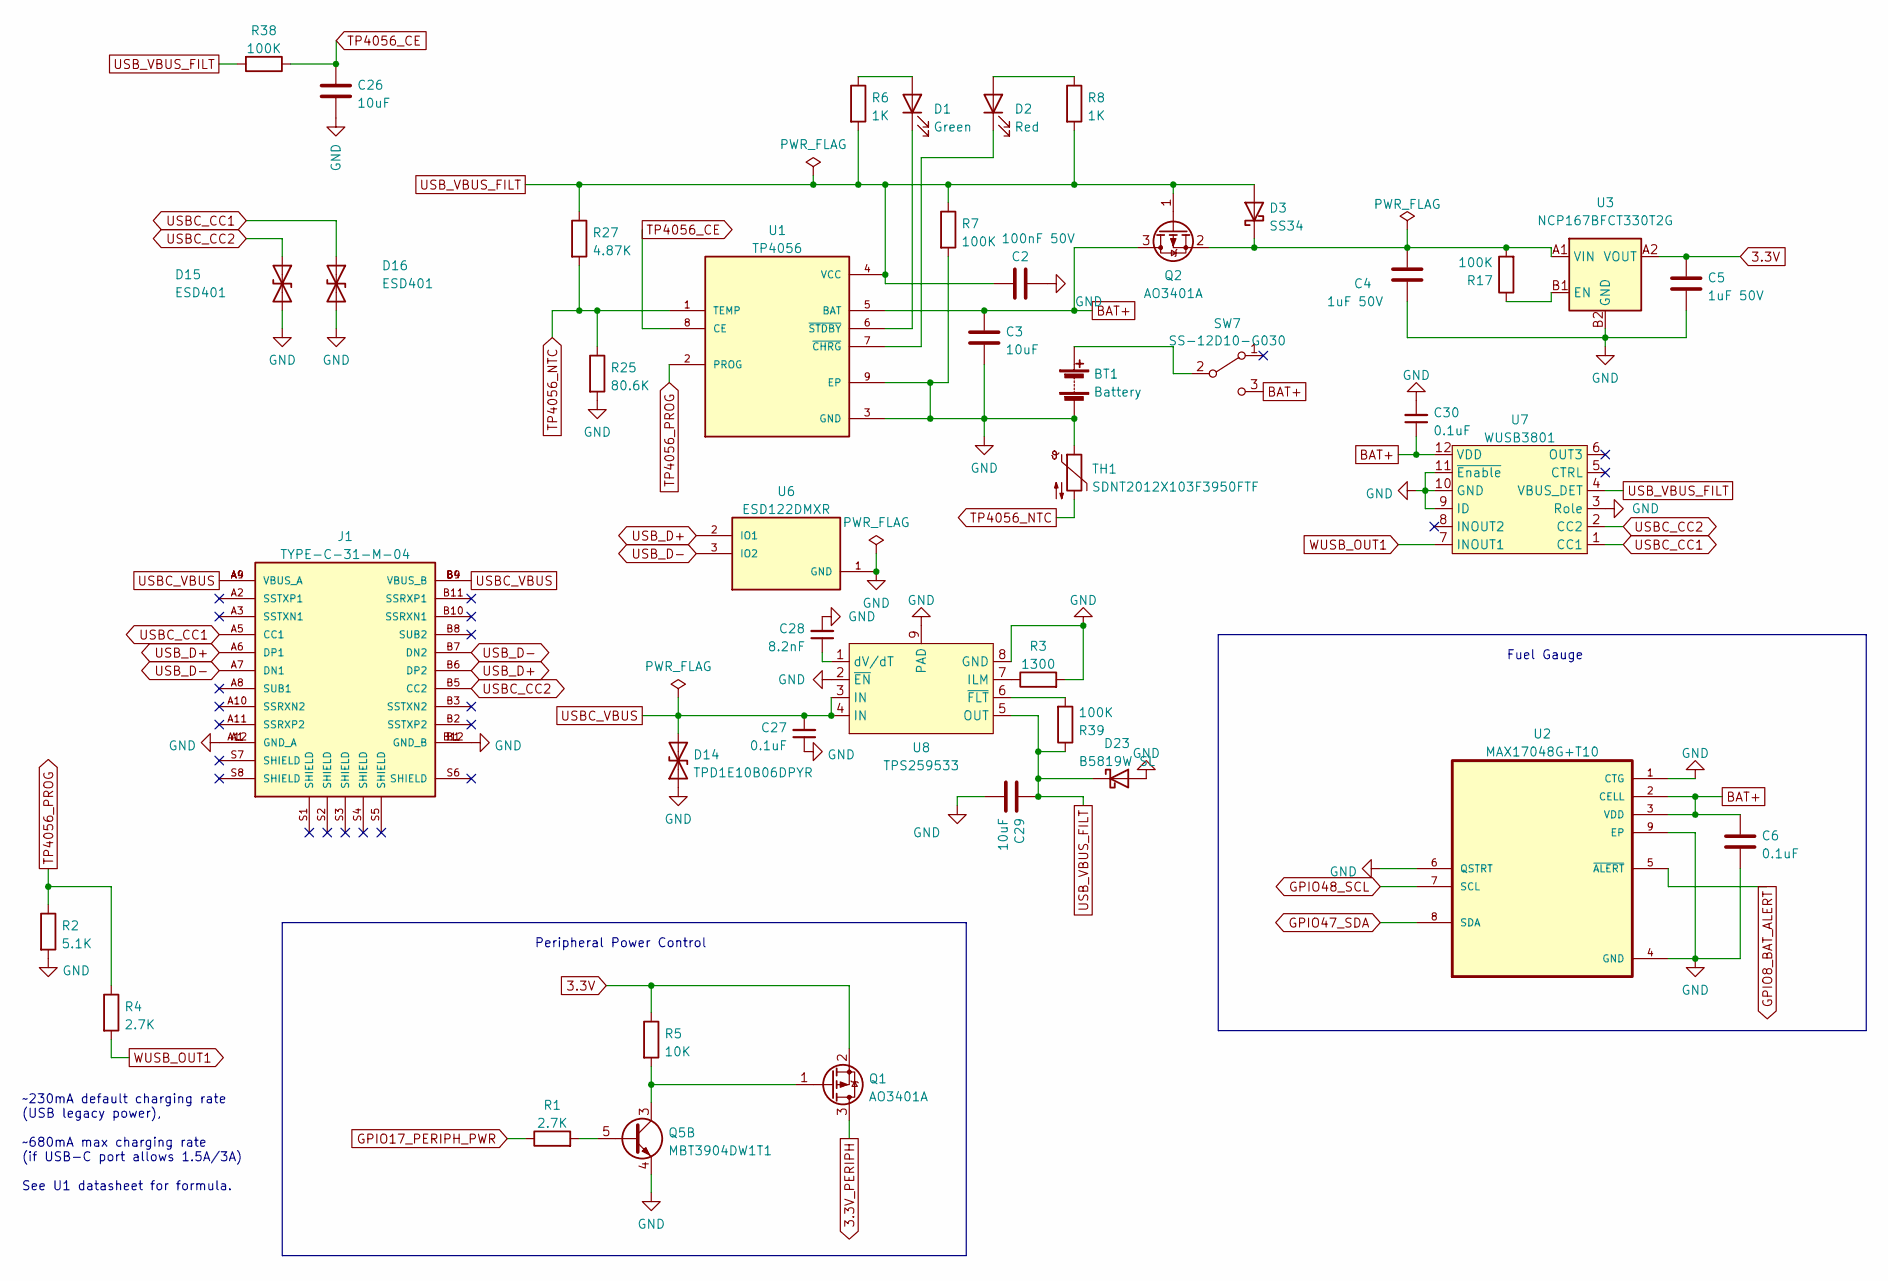
[picture p19: schematic power_and_usb.kicad_sch, ezDV]

Parts:
BT1: Battery; JST_PH_B2B-PH-K_1x02_P2.00mm_Vertical; LCSC C2319
C2: 100nF 50V; C_0402_1005Metric; LCSC C307331
C3, C26, C29: 10uF; C_0603_1608Metric; LCSC C96446
C4, C5: 1uF 50V; C_0805_2012Metric; LCSC C28323
C6, C27, C30: 0.1uF; C_0402_1005Metric; LCSC C1525
C28: 8.2nF; C_0402_1005Metric; LCSC C309459
D1: Green; D_0603_1608Metric; LCSC C72043
D2: Red; D_0603_1608Metric; LCSC C2286
D3: SS34; D_SMA; LCSC C8678
D14: TPD1E10B06DPYR; DIO_TPD1E05U06DPYR; LCSC C48260
D15, D16: ESD401; DIO_TPD1E05U06DPYR; LCSC C1974752
D23: B5819W SL; D_SOD-123; LCSC C8598
J1: TYPE-C-31-M-04; HRO_TYPE-C-31-M-04; PARTREV A; LCSC C129018
Q1, Q2: AO3401A; SOT-23; LCSC C15127
Q5: MBT3904DW1T1; SOT-363_SC-70-6; LCSC C110150
R1, R4: 2.7K; R_0603_1608Metric; LCSC C13167
R2: 5.1K; R_0402_1005Metric; LCSC C25905
R3: 1300; R_0402_1005Metric; LCSC C2974006
R5: 10K; R_0402_1005Metric; LCSC C25744
R6, R8: 1K; R_0402_1005Metric; LCSC C11702
R7, R17, R38, R39: 100K; R_0402_1005Metric; LCSC C25741
R25: 80.6K; R_0603_1608Metric; LCSC C103827
R27: 4.87K; R_0805_2012Metric; LCSC C104361
SW7: SS-12D10-G030; SS-12D10L3; LCSC C5155547
TH1: SDNT2012X103F3950FTF; R_0805_2012Metric; LCSC C95968
U1: TP4056; SOP127P600X175-9N; LCSC C16581
U2: MAX17048G+T10; SON50P200X200X80-9N; LCSC C2682616
U3: NCP167BFCT330T2G; BGA4N35P2X2_64X64X33N; LCSC C603663
U6: ESD122DMXR; IC_ESD122DMXR; PARTREV A; LCSC C544474
U7: WUSB3801; QFN1616-12L; LCSC C2931342
U8: TPS259533; WSON-8-1EP_2x2mm_P0.5mm_EP0.9x1.6mm_ThermalVias; LCSC C2155777

Connections:
3.3V: C5.1, Q1.2 (S), R5.1, U3.A2 (VOUT); also elsewhere on the board
3.3V_PERIPH: Q1.3 (D); also elsewhere on the board
BAT+: C3.1, C6.1, C30.1, Q2.3 (D), SW7.3 (C), U1.5 (BAT), U2.2 (CELL), U2.3 (VDD), U7.12 (VDD)
GND: BT1.2 (-), C2.1, C3.2, C4.2, C5.2, C6.2, C26.1, C27.1, C28.2, C29.2, C30.2, D14.1 (A1), D15.2 (A2), D16.2 (A2), D23.2 (A), J1.A1 (GND_A), J1.A12 (GND_A), J1.B1 (GND_B), J1.B12 (GND_B), Q5.4 (E2), R2.2, R3.2, R7.2, R25.2, TH1.1, U1.3 (GND), U1.9 (EP), U2.1 (CTG), U2.4 (GND), U2.6 (QSTRT), U2.9 (EP), U3.B2 (GND), U6.1 (GND), U7.3 (Role), U7.9 (ID), U7.10 (GND), U7.11 (~Enable), U8.2 (~EN), U8.8 (GND), U8.9 (PAD); also elsewhere on the board
GPIO8_BAT_ALERT: U2.5 (~ALERT); also elsewhere on the board
GPIO17_PERIPH_PWR: R1.1; also elsewhere on the board
GPIO47_SDA: U2.8 (SDA); also elsewhere on the board
GPIO48_SCL: U2.7 (SCL); also elsewhere on the board
unnamed: BT1.1 (+), SW7.2 (B)
unnamed: D1.2 (A), R6.1
unnamed: D1.1 (K), U1.6 (~STDBY)
unnamed: D2.2 (A), R8.1
unnamed: D2.1 (K), U1.7 (~CHRG)
unnamed: C4.1, D3.1 (K), Q2.2 (S), R17.2, U3.A1 (VIN)
unnamed: Q1.1 (G), Q5.3 (C2), R5.2
unnamed: Q5.5 (B2), R1.2
unnamed: R17.1, U3.B1 (EN)
unnamed: R3.1, U8.7 (ILM)
unnamed: C28.1, U8.1 (dV/dT)
unnamed: R39.2, U8.6 (~FLT)
TP4056_CE: C26.2, R38.1, U1.8 (CE)
TP4056_NTC: R25.1, R27.2, TH1.2, U1.1 (TEMP)
TP4056_PROG: R2.1, R4.1, U1.2 (PROG)
USBC_CC1: D16.1 (A1), J1.A5 (CC1), U7.1 (CC1)
USBC_CC2: D15.1 (A1), J1.B5 (CC2), U7.2 (CC2)
USBC_VBUS: C27.2, D14.2 (A2), J1.A4 (VBUS_A), J1.A9 (VBUS_A), J1.B4 (VBUS_B), J1.B9 (VBUS_B), U8.3 (IN), U8.4 (IN)
USB_D+: J1.A6 (DP1), J1.B6 (DP2), U6.2 (IO1); also elsewhere on the board
USB_D-: J1.A7 (DN1), J1.B7 (DN2), U6.3 (IO2); also elsewhere on the board
USB_VBUS_FILT: C2.2, C29.1, D3.2 (A), D23.1 (K), Q2.1 (G), R6.2, R7.1, R8.2, R27.1, R38.2, R39.1, U1.4 (VCC), U7.4 (VBUS_DET), U8.5 (OUT); also elsewhere on the board
WUSB_OUT1: R4.2, U7.7 (INOUT1)

Notes on the sheet:
Fuel Gauge
Peripheral Power Control
~230mA default charging rate (USB legacy power), ~680mA max charging rate (if USB-C port allows 1.5A/3A) See U1 datasheet for formula.

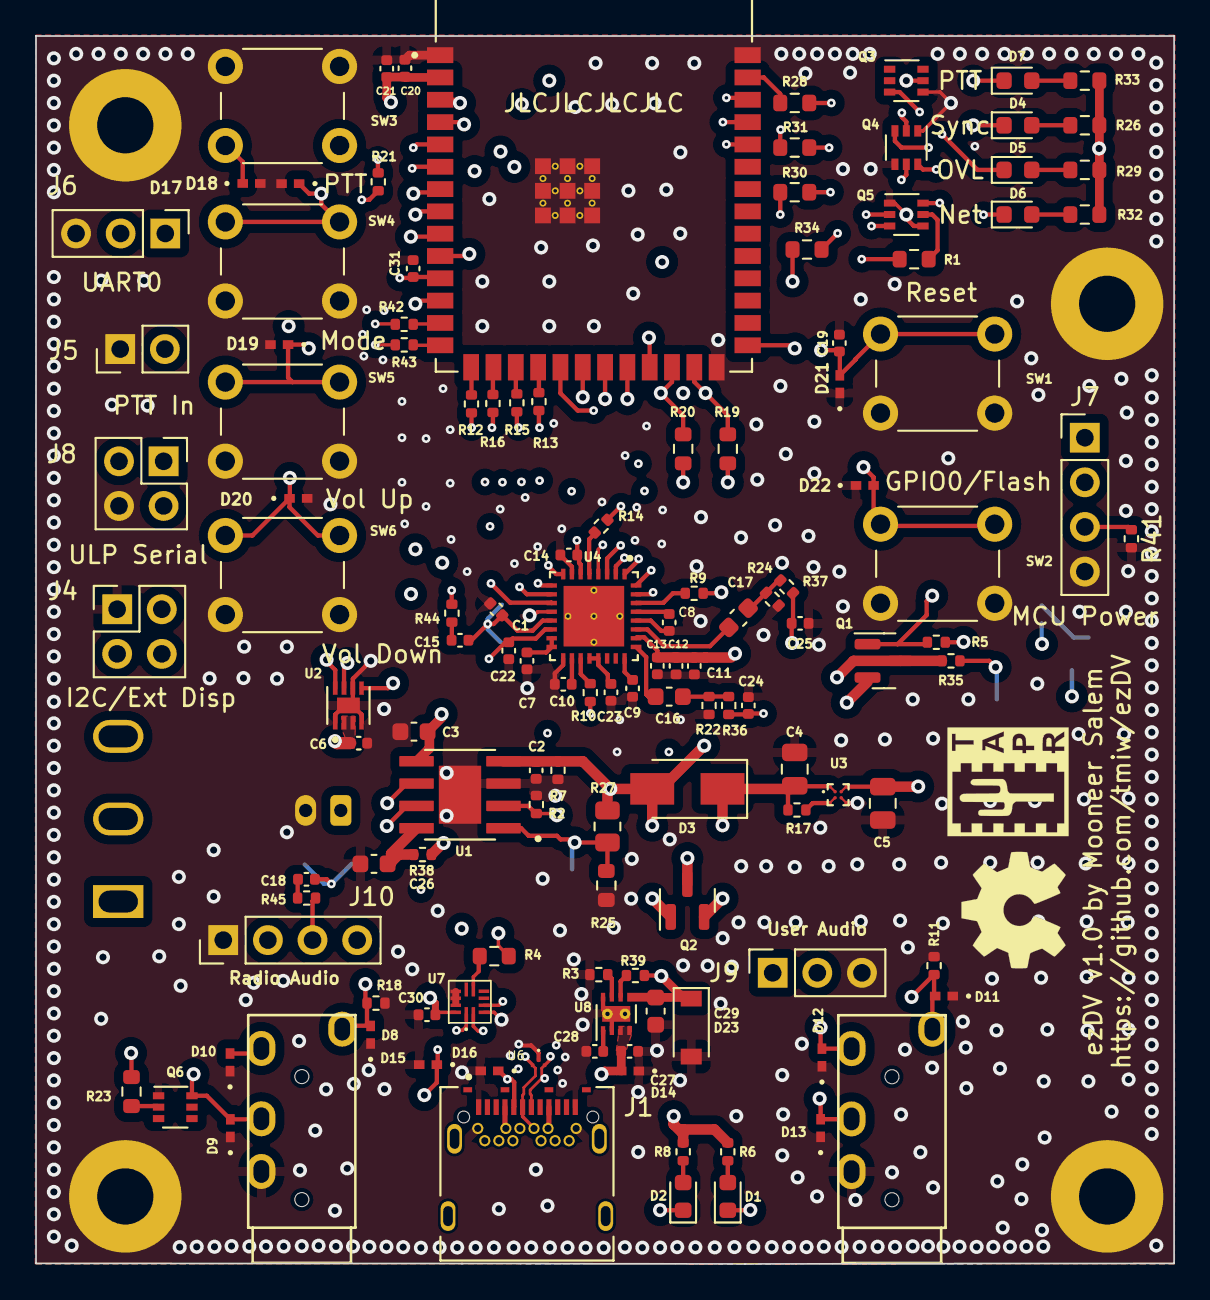
[picture p20: board ezDV.kicad_pcb from above]

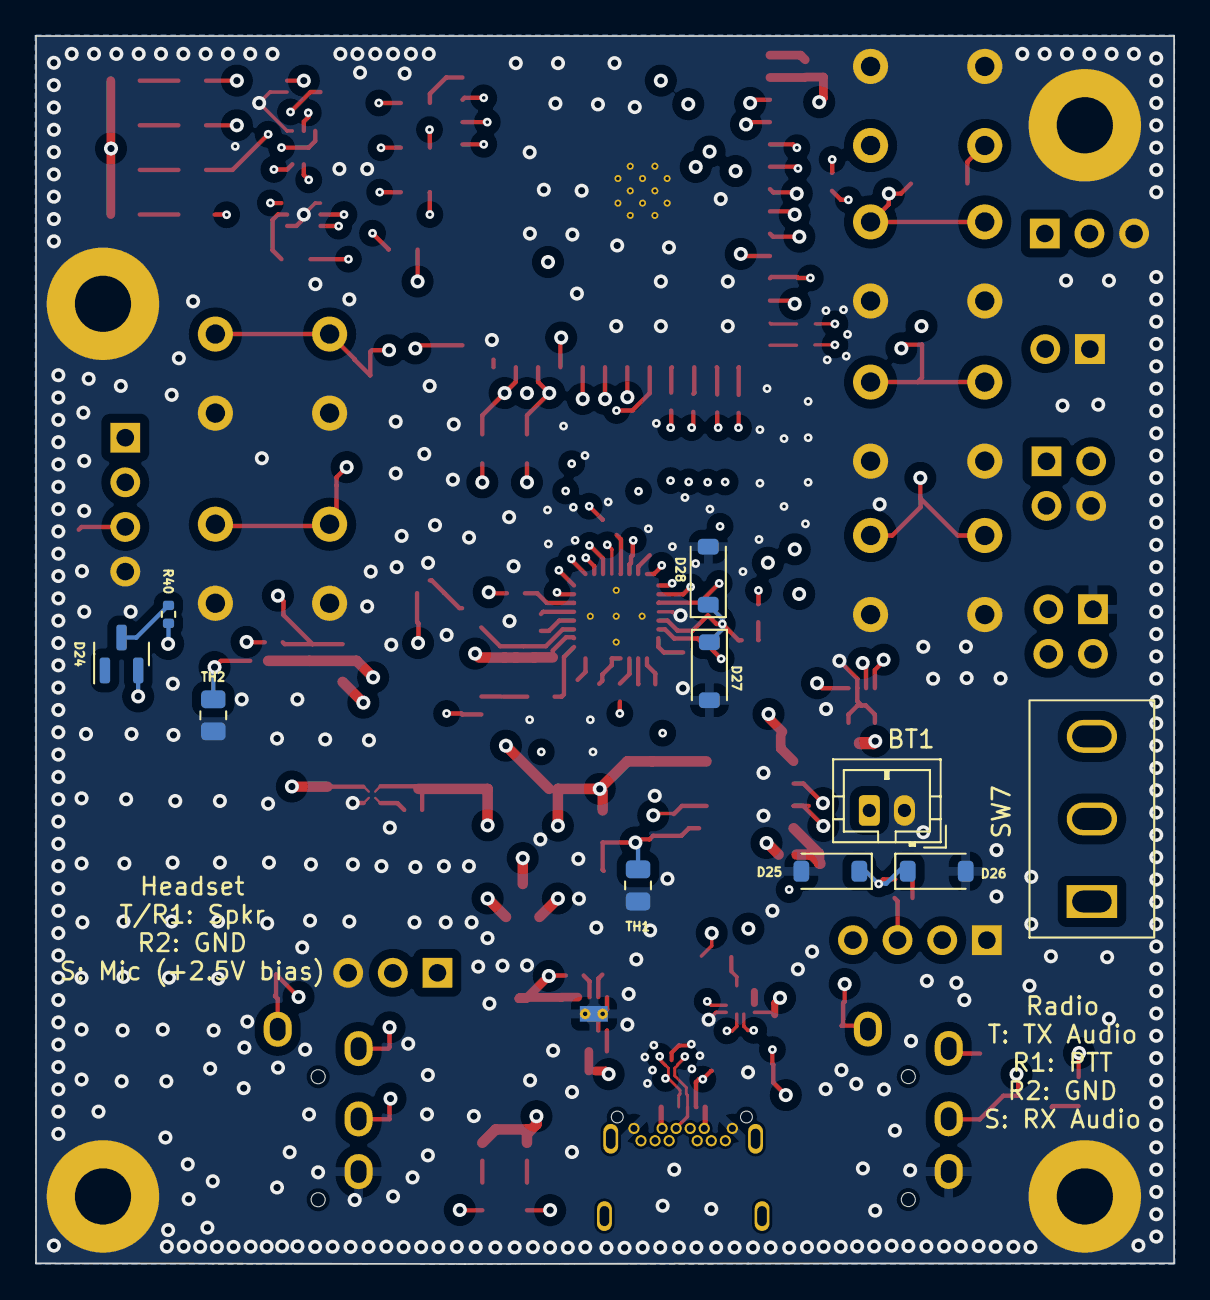
[picture p21: board ezDV.kicad_pcb from below]

Board: 6 copper layers, 64.8 x 69.9 mm, 142 parts (10 on the bottom side), 93 nets.
